iThinkiKhan/Gladiator/hardware/README.md

# Hardware & CAD

Gladiator operates much like a tank: one 12V motor on each track, powered from the battery pack. The tracks give it tremendous all-terrain capability, and the motors have enough torque to really crank the bot forward.

The masthead has pan and tilt. The pan mechanism uses a belt and pulley to get a real 180-degree flip so it can present the display face.

The motor drivers are the main way of getting heat out. Their mounts were designed to look cool, take up minimal room without expanding the bot's footprint, vent heat well, and provide easy access to the electronics. Most of the redesigns have been about access for tools and maintenance. The primary design has remained largely the same.

[Project](../README.md) · [CAD file catalog](cad/catalog.csv) · [Bill of materials](BOM.csv)

## Component snapshots

| Component | Revision note |
| --- | --- |
| [Chassis master](cad/chassis/README.md) | Reference assembly; embedded early head is historical |
| [Mast-front head assembly](cad/head-assembly/README.md) | Viewing assembly; source head prototype v05 |
| [Head v05](cad/head-parts/README.md) | Sensor-mount revision |
| [Camera service mount v2](cad/camera-mount/README.md) | Review assembly and printable tray/lid |
| [Arch rails v4](cad/rails/README.md) | Selected arch rail revision |
| [Upper deck v4](cad/upper-deck/README.md) | Measured rail fit revision |
| [Antenna pylon v3](cad/antenna-pylon/README.md) | Selected pylon revision |
| [INA226 mount v3](cad/power-sensor-mount/README.md) | Selected upright adapter |
| [Switch holder v3](cad/switch-holder/README.md) | Selected rear-open holder |
| [Speaker rail bracket v1](cad/speaker-mount/README.md) | Selected bracket revision |
| [Motor driver mounts v5](cad/motor-driver-mounts/README.md) | Selected interlocking mount revision |
| [Power tray v5](cad/power-tray/README.md) | Selected tray revision |
| [Mast base reprint](cad/mast-base/README.md) | Selected reprint revision |
| [Mast tube v2](cad/mast-tube/README.md) | Only the taller tube; other build2 parts superseded |
| [Round 5 body shell](cad/body-shell/README.md) | Mount-corrected 2.8 mm M2 derivative |
| [Shield emblems v2](cad/shield-emblems/README.md) | Stronger emblems and support cradle; supersedes shell emblem mesh |
| [M2 insert fit coupon](cad/insert-fit-coupon/README.md) | 2.8 mm bore accepted in source notes |

## Planned revisions

[Masthead revisions v1](../docs/PROJECT.md#masthead-revisions-v1)

## Assembly

<!-- WRITE: Your assembly notes. -->

## Printing

<!-- WRITE: Your material, slicer and assembly guidance. -->

Native FreeCAD, STEP and STL snapshots are included. Machine-specific G-code and slicer projects stay in the original source archive. The stronger v2 shield emblems supersede the emblem meshes retained inside the complete shell snapshot.

## Engineering references

[Robot orientation](../docs/reference/ORIENTATION.md) · [Design reference](../docs/reference/GLADIATOR_DESIGN.md) · [Component reference](../docs/reference/components.md)

These are source snapshots, not a newly validated assembled release.
