iThinkiKhan/Gladiator/photos/README.md

# Photos

<!-- WRITE: Gallery introduction. -->

[Project](../README.md)

| Album | Photos |
| --- | ---: |
| [Chassis v1](01-chassis-v1/README.md) | 6 |
| [Chassis assembly](02-chassis-assembly/README.md) | 6 |
| [Robot v1](03-robot-v1/README.md) | 8 |
| [Robot v2](05-robot-v2/README.md) | 2 |
| [Event](06-event/README.md) | 2 |
