iThinkiKhan/Gladiator/photos/01-chassis-v1/README.md

# Chassis v1

<!-- WRITE: Chassis v1 introduction. -->

[All photos](../README.md)

### 20261005_125814.jpg

<!-- WRITE: Caption for 20261005_125814.jpg. -->

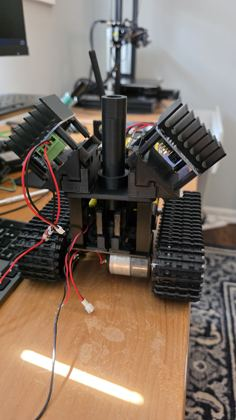
[picture p5: photos/thumbnails/01-chassis-v1/20261005_125814.jpg]
Chassis v1 — 2026-10-05


### 20261005_125831.jpg

<!-- WRITE: Caption for 20261005_125831.jpg. -->

Chassis v1 — 2026-10-05

### 20261005_125851.jpg

<!-- WRITE: Caption for 20261005_125851.jpg. -->

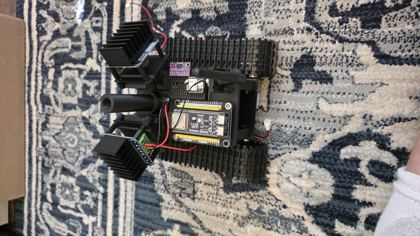
[picture p6: photos/thumbnails/01-chassis-v1/20261005_125851.jpg]
Chassis v1 — 2026-10-05


### 20261005_125855.jpg

<!-- WRITE: Caption for 20261005_125855.jpg. -->

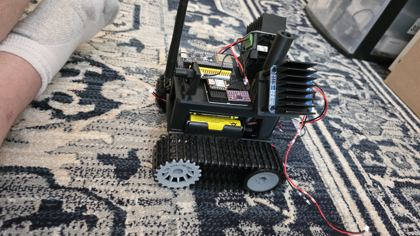
[picture p7: photos/thumbnails/01-chassis-v1/20261005_125855.jpg]
Chassis v1 — 2026-10-05


### 20261005_125901.jpg

<!-- WRITE: Caption for 20261005_125901.jpg. -->

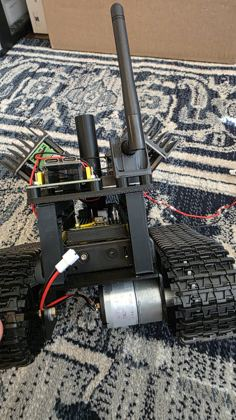
[picture p8: photos/thumbnails/01-chassis-v1/20261005_125901.jpg]
Chassis v1 — 2026-10-05


### 20261005_125914.jpg

<!-- WRITE: Caption for 20261005_125914.jpg. -->

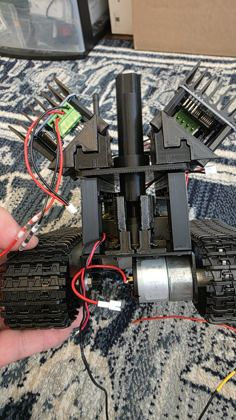
[picture p9: photos/thumbnails/01-chassis-v1/20261005_125914.jpg]
Chassis v1 — 2026-10-05
