iThinkiKhan/Gladiator/photos/04-enclosure-details/README.md

# Enclosure details

<!-- WRITE: Enclosure details introduction. -->

[All photos](../README.md)

### 20261021_211342.jpg

<!-- WRITE: Caption for 20261021_211342.jpg. -->

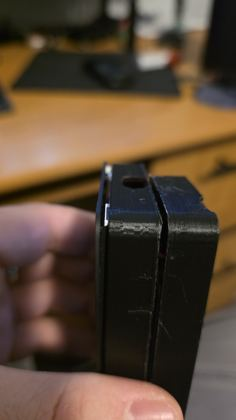
[picture p10: photos/thumbnails/04-enclosure-details/20261021_211342.jpg]
Enclosure details — 2026-10-21


### 20261021_211346.jpg

<!-- WRITE: Caption for 20261021_211346.jpg. -->

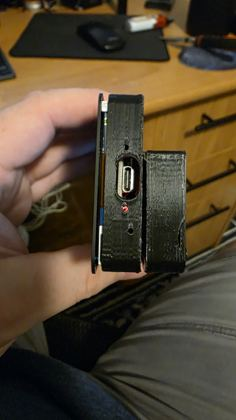
[picture p11: photos/thumbnails/04-enclosure-details/20261021_211346.jpg]
Enclosure details — 2026-10-21


### 20261022_091821.jpg

<!-- WRITE: Caption for 20261022_091821.jpg. -->

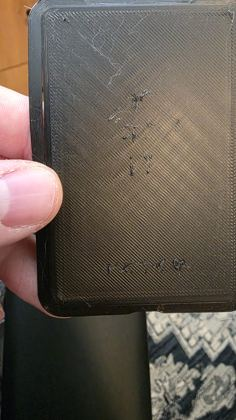
[picture p12: photos/thumbnails/04-enclosure-details/20261022_091821.jpg]
Enclosure details — 2026-10-22
