iThinkiKhan/Gladiator/hardware/cad/antenna-pylon/README.md

# Antenna pylon v3

<!-- WRITE: Antenna pylon v3 notes. -->

Selected pylon revision.

| File | Format |
| --- | --- |
| [Gladiator_AntennaPylon_v3.FCStd](Gladiator_AntennaPylon_v3.FCStd) | FCStd |
| [Gladiator_AntennaPylon_v3.step](Gladiator_AntennaPylon_v3.step) | step |
| [Gladiator_AntennaPylon_v3.stl](Gladiator_AntennaPylon_v3.stl) | stl |
| [pylon_v3_sections.png](pylon_v3_sections.png) | png |

Source revision: `v2/antenna-pylon/v3-20261014` in [gladiator-cad](https://github.com/iThinkiKhan/gladiator-cad/tree/db25f68d589b59520871f2c27f7898625261f611/cad/v2/antenna-pylon/v3-20261014).

[CAD index](../../README.md)
