iThinkiKhan/Gladiator/hardware/cad/body-shell/README.md

# Round 5 body shell

<!-- WRITE: Round 5 body shell notes. -->

Mount-corrected 2.8 mm M2 derivative.

| File | Format |
| --- | --- |
| [Gladiator_Round5_Print.FCStd](Gladiator_Round5_Print.FCStd) | FCStd |
| [Gladiator_Round5_PrintParts.step](Gladiator_Round5_PrintParts.step) | step |
| [Aquila_Relief.stl](stl/Aquila_Relief.stl) | stl |
| [Crest_Clamp.stl](stl/Crest_Clamp.stl) | stl |
| [Crest_Clamp_Shoe.stl](stl/Crest_Clamp_Shoe.stl) | stl |
| [Crest_Holder_Trim.stl](stl/Crest_Holder_Trim.stl) | stl |
| [Front_Left.stl](stl/Front_Left.stl) | stl |
| [Front_Right.stl](stl/Front_Right.stl) | stl |
| [Galea_Crest.stl](stl/Galea_Crest.stl) | stl |
| [Lens_Plate.stl](stl/Lens_Plate.stl) | stl |
| [Neck_Clamp_0.stl](stl/Neck_Clamp_0.stl) | stl |
| [Neck_Clamp_1.stl](stl/Neck_Clamp_1.stl) | stl |
| [Neck_Clamp_Shoe_21_5.stl](stl/Neck_Clamp_Shoe_21_5.stl) | stl |
| [Neck_Clamp_Shoe_57_5.stl](stl/Neck_Clamp_Shoe_57_5.stl) | stl |
| [Neck_Guard.stl](stl/Neck_Guard.stl) | stl |
| [Rear_Hood.stl](stl/Rear_Hood.stl) | stl |
| [Scutum_Boss_L.stl](stl/Scutum_Boss_L.stl) | stl |
| [Scutum_Boss_R.stl](stl/Scutum_Boss_R.stl) | stl |
| [Scutum_Emblem_L.stl](stl/Scutum_Emblem_L.stl) | stl |
| [Scutum_Emblem_R.stl](stl/Scutum_Emblem_R.stl) | stl |
| [Scutum_Field_L.stl](stl/Scutum_Field_L.stl) | stl |
| [Scutum_Field_R.stl](stl/Scutum_Field_R.stl) | stl |
| [Tablet_L.stl](stl/Tablet_L.stl) | stl |
| [Tablet_R.stl](stl/Tablet_R.stl) | stl |

Source revision: `v2/enclosure/round5-calibrated-28-20261022/mount-checked-release/DELIVERY/CAD` in [gladiator-cad](https://github.com/iThinkiKhan/gladiator-cad/tree/db25f68d589b59520871f2c27f7898625261f611/cad/v2/enclosure/round5-calibrated-28-20261022/mount-checked-release/DELIV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).

[CAD index](../../README.md)
