iThinkiKhan/Gladiator/hardware/cad/camera-mount/README.md

# Camera service mount v2

<!-- WRITE: Camera service mount v2 notes. -->

Review assembly and printable tray/lid.

| File | Format |
| --- | --- |
| [assembled.png](assembled.png) | png |
| [exploded.png](exploded.png) | png |
| [Gladiator_Camera_Service_v2.step](Gladiator_Camera_Service_v2.step) | step |
| [Gladiator_Camera_Service_v2_REVIEW.FCStd](Gladiator_Camera_Service_v2_REVIEW.FCStd) | FCStd |
| [Camera_Service_v2_Lid.stl](stl/Camera_Service_v2_Lid.stl) | stl |
| [Camera_Service_v2_Tray.stl](stl/Camera_Service_v2_Tray.stl) | stl |

Source revision: `head/camera-service-v2-20261021` in [gladiator-cad](https://github.com/iThinkiKhan/gladiator-cad/tree/db25f68d589b59520871f2c27f7898625261f611/cad/head/camera-service-v2-20261021).

[CAD index](../../README.md)
