iThinkiKhan/Gladiator/hardware/cad/chassis/README.md

# Chassis master

<!-- WRITE: Chassis master notes. -->

Reference assembly; embedded early head is historical.

| File | Format |
| --- | --- |
| [Gladiator_Master.FCStd](Gladiator_Master.FCStd) | FCStd |
| [Gladiator_Master.step](Gladiator_Master.step) | step |

Source revision: `master` in [gladiator-cad](https://github.com/iThinkiKhan/gladiator-cad/tree/db25f68d589b59520871f2c27f7898625261f611/cad/master).

[CAD index](../../README.md)
