iThinkiKhan/Gladiator/hardware/cad/insert-fit-coupon/README.md

# M2 insert fit coupon

<!-- WRITE: M2 insert fit coupon notes. -->

2.8 mm bore accepted in source notes.

| File | Format |
| --- | --- |
| [M2_D3_L3_Coupon.FCStd](M2_D3_L3_Coupon.FCStd) | FCStd |
| [M2_D3_L3_Coupon.step](M2_D3_L3_Coupon.step) | step |
| [M2_D3_L3_Coupon.stl](M2_D3_L3_Coupon.stl) | stl |

Source revision: `coupons/m2-d3-l3-mini-20261022` in [gladiator-cad](https://github.com/iThinkiKhan/gladiator-cad/tree/db25f68d589b59520871f2c27f7898625261f611/cad/coupons/m2-d3-l3-mini-20261022).

[CAD index](../../README.md)
