iThinkiKhan/Gladiator/hardware/cad/mast-base/README.md

# Mast base reprint

<!-- WRITE: Mast base reprint notes. -->

Selected reprint revision.

| File | Format |
| --- | --- |
| [Gladiator_MastBase_spigot-3p5_chamfer-0p8_UP.stl](Gladiator_MastBase_spigot-3p5_chamfer-0p8_UP.stl) | stl |
| [Gladiator_Master_MastBase_short-spigot.FCStd](Gladiator_Master_MastBase_short-spigot.FCStd) | FCStd |

Source revision: `mast-base/reprint-20260926` in [gladiator-cad](https://github.com/iThinkiKhan/gladiator-cad/tree/db25f68d589b59520871f2c27f7898625261f611/cad/mast-base/reprint-20260926).

[CAD index](../../README.md)
