iThinkiKhan/Gladiator/hardware/cad/mast-tube/README.md

# Mast tube v2

<!-- WRITE: Mast tube v2 notes. -->

Only the taller tube; other build2 parts superseded.

| File | Format |
| --- | --- |
| [Gladiator_MastTube_v2-Z130_print-vertical.stl](Gladiator_MastTube_v2-Z130_print-vertical.stl) | stl |

Source revision: `build2-20260927` in [gladiator-cad](https://github.com/iThinkiKhan/gladiator-cad/tree/db25f68d589b59520871f2c27f7898625261f611/cad/build2-20260927).

[CAD index](../../README.md)
