iThinkiKhan/Gladiator/hardware/cad/motor-driver-mounts/README.md

# Motor driver mounts v5

<!-- WRITE: Motor driver mounts v5 notes. -->

Selected interlocking mount revision.

| File | Format |
| --- | --- |
| [DriverMount_v5.FCStd](DriverMount_v5.FCStd) | FCStd |
| [DriverMount_v5.step](DriverMount_v5.step) | step |
| [Base_Left.stl](stl/Base_Left.stl) | stl |
| [Wedge_Left.stl](stl/Wedge_Left.stl) | stl |

Source revision: `drivers/v5-interlock` in [gladiator-cad](https://github.com/iThinkiKhan/gladiator-cad/tree/db25f68d589b59520871f2c27f7898625261f611/cad/drivers/v5-interlock).

[CAD index](../../README.md)
