iThinkiKhan/Gladiator/hardware/cad/power-sensor-mount/README.md

# INA226 mount v3

<!-- WRITE: INA226 mount v3 notes. -->

Selected upright adapter.

| File | Format |
| --- | --- |
| [Gladiator_INA_Mount_v3.FCStd](Gladiator_INA_Mount_v3.FCStd) | FCStd |
| [Gladiator_INA_Mount_v3.step](Gladiator_INA_Mount_v3.step) | step |
| [Gladiator_INA_Mount_v3.stl](Gladiator_INA_Mount_v3.stl) | stl |

Source revision: `v2/ina-mount/v3-20261019` in [gladiator-cad](https://github.com/iThinkiKhan/gladiator-cad/tree/db25f68d589b59520871f2c27f7898625261f611/cad/v2/ina-mount/v3-20261019).

[CAD index](../../README.md)
