iThinkiKhan/Gladiator/hardware/cad/power-tray/README.md

# Power tray v5

<!-- WRITE: Power tray v5 notes. -->

Selected tray revision.

| File | Format |
| --- | --- |
| [PowerBoardTray_v5.FCStd](PowerBoardTray_v5.FCStd) | FCStd |
| [PowerBoardTray_v5.step](PowerBoardTray_v5.step) | step |
| [Gladiator_PowerTray_v5_BaseLeft_print-tab-down.stl](stl/Gladiator_PowerTray_v5_BaseLeft_print-tab-down.stl) | stl |
| [Gladiator_PowerTray_v5_BaseRight_print-tab-down.stl](stl/Gladiator_PowerTray_v5_BaseRight_print-tab-down.stl) | stl |
| [Gladiator_PowerTray_v5_FitCoupon_base-and-peg.stl](stl/Gladiator_PowerTray_v5_FitCoupon_base-and-peg.stl) | stl |
| [Gladiator_PowerTray_v5_print-on-rear-face.stl](stl/Gladiator_PowerTray_v5_print-on-rear-face.stl) | stl |
| [PowerBoardTray_v5_installed.stl](stl/PowerBoardTray_v5_installed.stl) | stl |

Source revision: `power-board/v5-tray` in [gladiator-cad](https://github.com/iThinkiKhan/gladiator-cad/tree/db25f68d589b59520871f2c27f7898625261f611/cad/power-board/v5-tray).

[CAD index](../../README.md)
