iThinkiKhan/Gladiator/hardware/cad/rails/README.md

# Arch rails v4

<!-- WRITE: Arch rails v4 notes. -->

Selected arch rail revision.

| File | Format |
| --- | --- |
| [arch_rails_v4_sections.png](arch_rails_v4_sections.png) | png |
| [Gladiator_Arch_Rail_Left_v4.stl](Gladiator_Arch_Rail_Left_v4.stl) | stl |
| [Gladiator_Arch_Rail_Right_v4.stl](Gladiator_Arch_Rail_Right_v4.stl) | stl |
| [Gladiator_ArchRails_v4.FCStd](Gladiator_ArchRails_v4.FCStd) | FCStd |
| [Gladiator_ArchRails_v4.step](Gladiator_ArchRails_v4.step) | step |

Source revision: `v2/rails/v4-20261015` in [gladiator-cad](https://github.com/iThinkiKhan/gladiator-cad/tree/db25f68d589b59520871f2c27f7898625261f611/cad/v2/rails/v4-20261015).

[CAD index](../../README.md)
