iThinkiKhan/Gladiator/hardware/cad/shield-emblems/README.md

# Shield emblems v2

<!-- WRITE: Shield emblems v2 notes. -->

Stronger emblems and support cradle; supersedes shell emblem mesh.

| File | Format |
| --- | --- |
| [Emblem_Cradle.stl](Emblem_Cradle.stl) | stl |
| [emblem_old_right_v2_left.png](emblem_old_right_v2_left.png) | png |
| [Scutum_Emblem_v2.FCStd](Scutum_Emblem_v2.FCStd) | FCStd |
| [Scutum_Emblem_v2.stl](Scutum_Emblem_v2.stl) | stl |

Source revision: `v2/enclosure/round5-print-20261022/emblem-v2` in [gladiator-cad](https://github.com/iThinkiKhan/gladiator-cad/tree/db25f68d589b59520871f2c27f7898625261f611/cad/v2/enclosure/round5-print-20261022/emblem-v2).

[CAD index](../../README.md)
