iThinkiKhan/Gladiator/hardware/cad/speaker-mount/README.md

# Speaker rail bracket v1

<!-- WRITE: Speaker rail bracket v1 notes. -->

Selected bracket revision.

| File | Format |
| --- | --- |
| [Gladiator_Speaker_Rail_Bracket_v1.FCStd](Gladiator_Speaker_Rail_Bracket_v1.FCStd) | FCStd |
| [Gladiator_Speaker_Rail_Bracket_v1.step](Gladiator_Speaker_Rail_Bracket_v1.step) | step |
| [Gladiator_Speaker_Rail_Bracket_v1.stl](Gladiator_Speaker_Rail_Bracket_v1.stl) | stl |

Source revision: `v2/speaker-mount/v1-20261020` in [gladiator-cad](https://github.com/iThinkiKhan/gladiator-cad/tree/db25f68d589b59520871f2c27f7898625261f611/cad/v2/speaker-mount/v1-20261020).

[CAD index](../../README.md)
