iThinkiKhan/Gladiator/hardware/cad/switch-holder/README.md

# Switch holder v3

<!-- WRITE: Switch holder v3 notes. -->

Selected rear-open holder.

| File | Format |
| --- | --- |
| [Gladiator_SwitchHolder_v3.FCStd](Gladiator_SwitchHolder_v3.FCStd) | FCStd |
| [Gladiator_SwitchHolder_v3.step](Gladiator_SwitchHolder_v3.step) | step |
| [Gladiator_SwitchHolder_v3.stl](Gladiator_SwitchHolder_v3.stl) | stl |

Source revision: `v2/switch-enclosure/v3-20261016` in [gladiator-cad](https://github.com/iThinkiKhan/gladiator-cad/tree/db25f68d589b59520871f2c27f7898625261f611/cad/v2/switch-enclosure/v3-20261016).

[CAD index](../../README.md)
