iThinkiKhan/Gladiator/hardware/cad/upper-deck/README.md

# Upper deck v4

<!-- WRITE: Upper deck v4 notes. -->

Measured rail fit revision.

| File | Format |
| --- | --- |
| [Gladiator_UpperDeck_v4.FCStd](Gladiator_UpperDeck_v4.FCStd) | FCStd |
| [Gladiator_UpperDeck_v4.step](Gladiator_UpperDeck_v4.step) | step |
| [Gladiator_UpperDeck_v4.stl](Gladiator_UpperDeck_v4.stl) | stl |

Source revision: `v2/upper-deck/v4-20261016` in [gladiator-cad](https://github.com/iThinkiKhan/gladiator-cad/tree/db25f68d589b59520871f2c27f7898625261f611/cad/v2/upper-deck/v4-20261016).

[CAD index](../../README.md)
