iThinkiKhan/Gladiator/docs/EDITING.md

# Writing your project

- [Main README](../README.md): review the opening and status in your words; add features, credits and licensing.
- [Project story](PROJECT.md): your origin story, power board, body redesign and next steps; refine or extend it as we go.
- [Build log](BUILD_LOG.md): your notes beside each linked photo album.
- [Hardware](../hardware/README.md): assembly and printing guidance.
- [Bill of materials](../hardware/BOM.csv): fill quantities, specifications and notes.
- [Firmware](../firmware/README.md): add your software overview above the build reference.
- [Photo albums](../photos/README.md): fill each introduction and caption.

Search for `<!-- WRITE:` to find each writing slot. Comments are hidden in the rendered pages. Leave source code and generated catalogs alone unless you are changing the project itself.

Choose licensing for code, hardware, and photos, and add any required third-party credits before describing this as an open-source release. No license was selected on your behalf.
