iThinkiKhan/Gladiator/photos/06-event/README.md

# Event

<!-- WRITE: Event introduction. -->

[All photos](../README.md)

### 20261024_125802.jpg

<!-- WRITE: Caption for 20261024_125802.jpg. -->

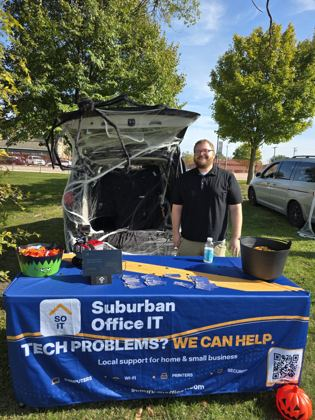
[picture p13: photos/thumbnails/06-event/20261024_125802.jpg]
Event — 2026-10-24


### 20261024_125804.jpg

<!-- WRITE: Caption for 20261024_125804.jpg. -->

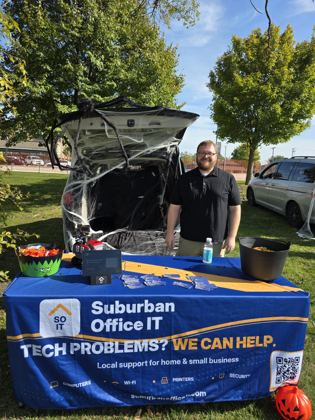
[picture p14: photos/thumbnails/06-event/20261024_125804.jpg]
Event — 2026-10-24
