iThinkiKhan/Gladiator/photos/03-robot-v1/README.md

# Robot v1

<!-- WRITE: Robot v1 introduction. -->

[All photos](../README.md)

### 20261014_103027.jpg

<!-- WRITE: Caption for 20261014_103027.jpg. -->

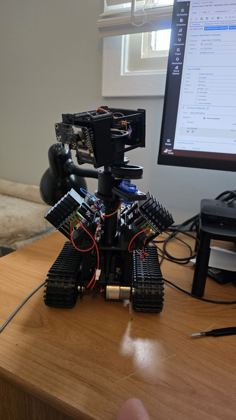
[picture p15: photos/thumbnails/03-robot-v1/20261014_103027.jpg]
Robot v1 — 2026-10-14


### 20261014_103030.jpg

<!-- WRITE: Caption for 20261014_103030.jpg. -->

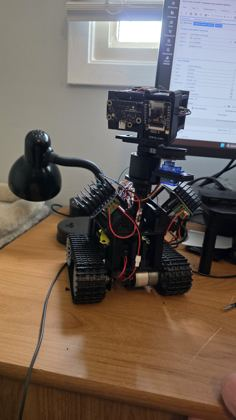
[picture p16: photos/thumbnails/03-robot-v1/20261014_103030.jpg]
Robot v1 — 2026-10-14


### 20261014_114522.jpg

<!-- WRITE: Caption for 20261014_114522.jpg. -->

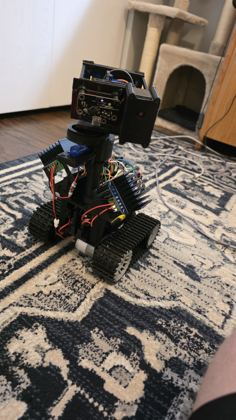
[picture p17: photos/thumbnails/03-robot-v1/20261014_114522.jpg]
Robot v1 — 2026-10-14


### 20261014_114531.jpg

<!-- WRITE: Caption for 20261014_114531.jpg. -->

Robot v1 — 2026-10-14

### 20261014_114604.jpg

<!-- WRITE: Caption for 20261014_114604.jpg. -->

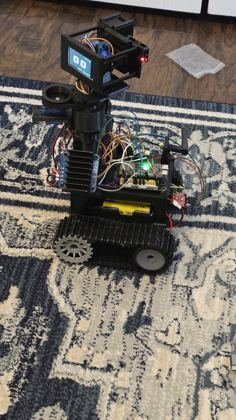
[picture p18: photos/thumbnails/03-robot-v1/20261014_114604.jpg]
Robot v1 — 2026-10-14


### 20261014_160522.jpg

<!-- WRITE: Caption for 20261014_160522.jpg. -->

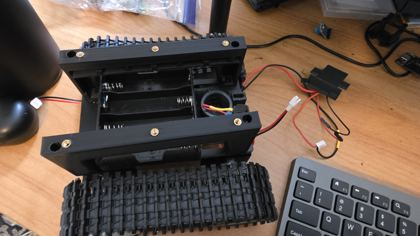
[picture p19: photos/thumbnails/03-robot-v1/20261014_160522.jpg]
Robot v1 — 2026-10-14


### 20261014_160528.jpg

<!-- WRITE: Caption for 20261014_160528.jpg. -->

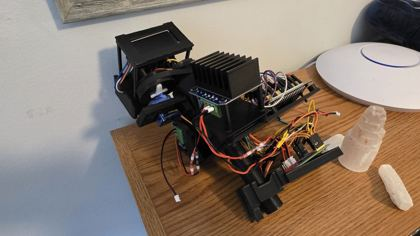
[picture p20: photos/thumbnails/03-robot-v1/20261014_160528.jpg]
Robot v1 — 2026-10-14


### 20261014_160530.jpg

<!-- WRITE: Caption for 20261014_160530.jpg. -->

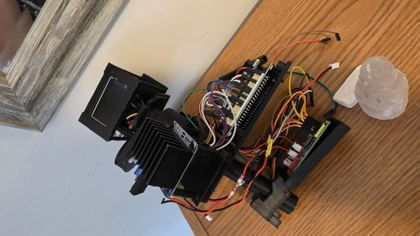
[picture p21: photos/thumbnails/03-robot-v1/20261014_160530.jpg]
Robot v1 — 2026-10-14
