iThinkiKhan/Gladiator/photos/05-robot-v2/README.md

# Robot v2

<!-- WRITE: Robot v2 introduction. -->

[All photos](../README.md)

### 20261026_121424.jpg

<!-- WRITE: Caption for 20261026_121424.jpg. -->

Robot v2 — 2026-10-26

### 20261026_121446.jpg

<!-- WRITE: Caption for 20261026_121446.jpg. -->

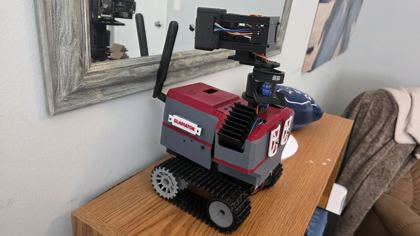
[picture p22: photos/thumbnails/05-robot-v2/20261026_121446.jpg]
Robot v2 — 2026-10-26
