iThinkiKhan/Gladiator/hardware/cad/antenna-pylon/pylon_v3_sections.png

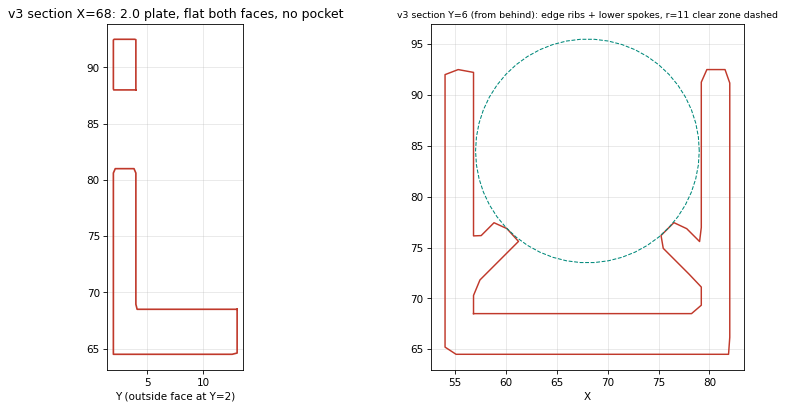
hardware/cad/antenna-pylon/pylon_v3_sections.png
