iThinkiKhan/Gladiator/hardware/cad/camera-mount/exploded.png

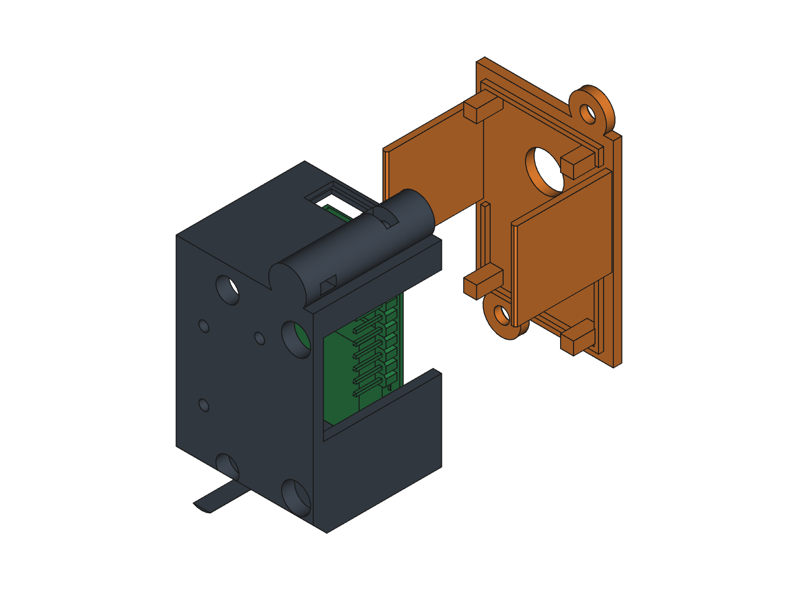
hardware/cad/camera-mount/exploded.png
