iThinkiKhan/Gladiator/hardware/cad/rails/arch_rails_v4_sections.png

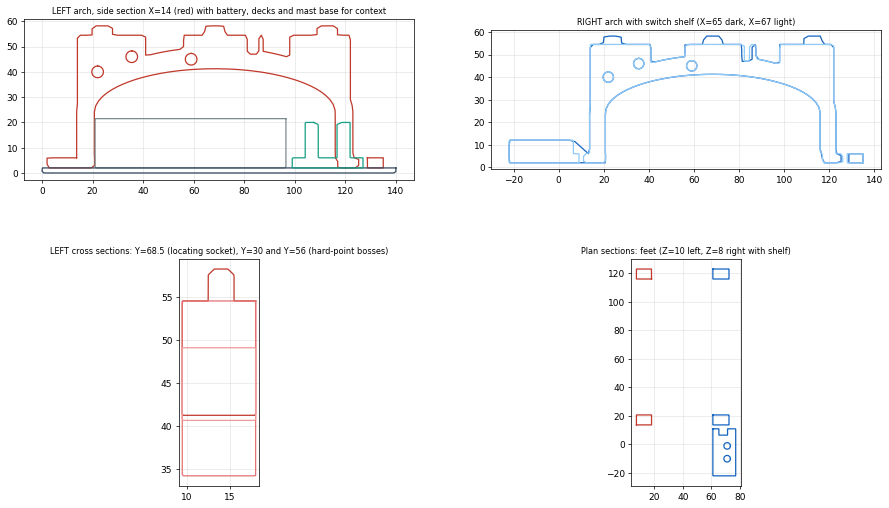
hardware/cad/rails/arch_rails_v4_sections.png
