iThinkiKhan/Gladiator/photos/06-event/20261024_134534.jpg

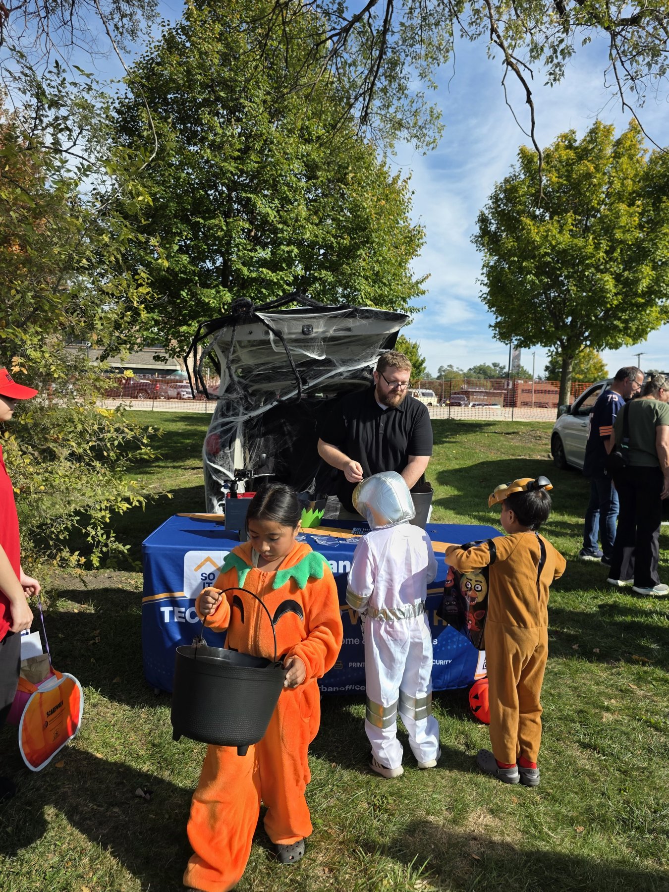
photos/06-event/20261024_134534.jpg
