iThinkiKhan/Gladiator/photos/06-event/20261024_134554.jpg

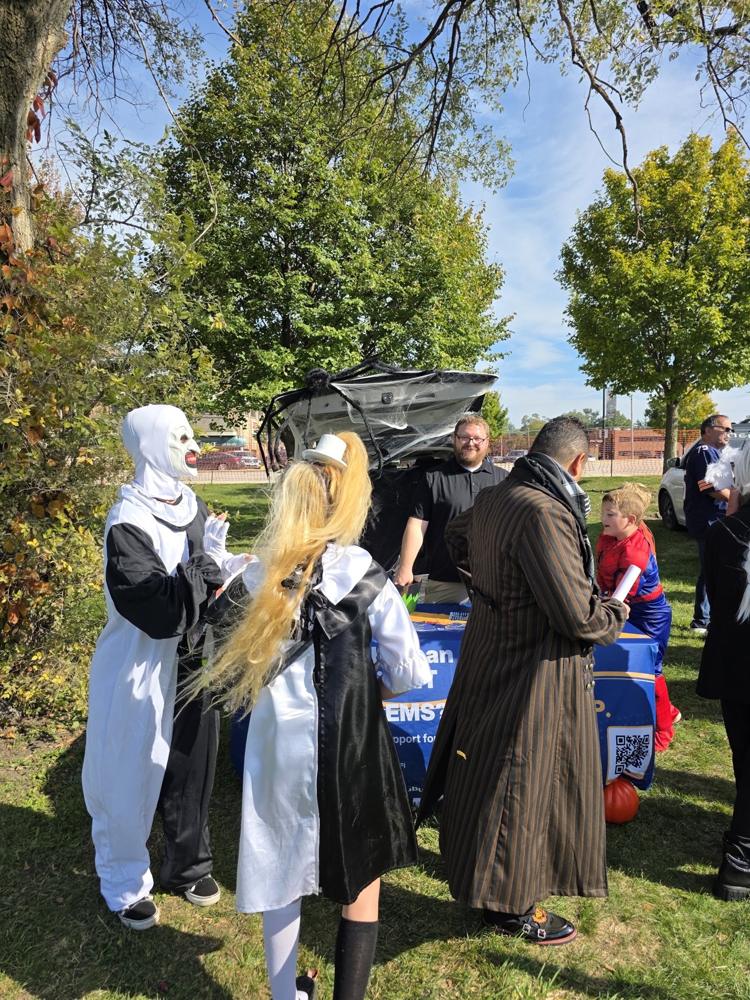
photos/06-event/20261024_134554.jpg
