iThinkiKhan/Gladiator/photos/06-event/20261024_141302.jpg

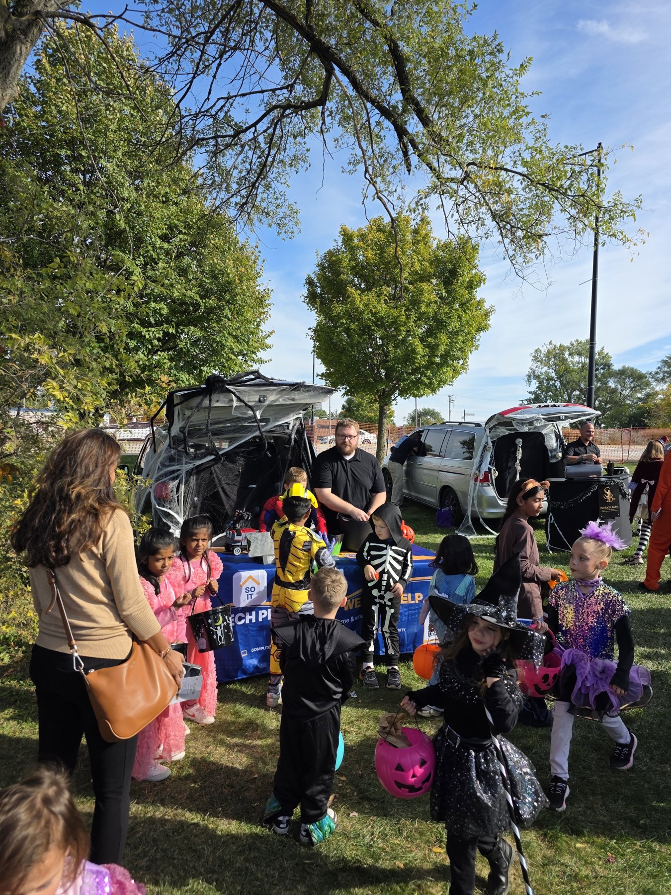
photos/06-event/20261024_141302.jpg
