iThinkiKhan/Gladiator/hardware/cad/head-parts/README.md

# Head v05

<!-- WRITE: Head v05 notes. -->

Sensor-mount revision.

| File | Format |
| --- | --- |
| [Gladiator_Head_v05_PanStack.FCStd](Gladiator_Head_v05_PanStack.FCStd) | FCStd |
| [Gladiator_Head_v05_PanStack.step](Gladiator_Head_v05_PanStack.step) | step |
| [sensor-mounts.png](sensor-mounts.png) | png |
| [Gladiator_Head_v05_GH44_Dual_Carrier.stl](stl/Gladiator_Head_v05_GH44_Dual_Carrier.stl) | stl |
| [Gladiator_Head_v05_GH44_Tilt_Receiver.stl](stl/Gladiator_Head_v05_GH44_Tilt_Receiver.stl) | stl |
| [Gladiator_Head_v05_Neck_Clamp_Cap.stl](stl/Gladiator_Head_v05_Neck_Clamp_Cap.stl) | stl |
| [Gladiator_Head_v05_Neck_Main.stl](stl/Gladiator_Head_v05_Neck_Main.stl) | stl |
| [Gladiator_Head_v05_Pan_Drive_Pulley.stl](stl/Gladiator_Head_v05_Pan_Drive_Pulley.stl) | stl |
| [Gladiator_Head_v05_Pan_Raised_Pedestal.stl](stl/Gladiator_Head_v05_Pan_Raised_Pedestal.stl) | stl |
| [Gladiator_Head_v05_Pan_Retainer.stl](stl/Gladiator_Head_v05_Pan_Retainer.stl) | stl |
| [Gladiator_Head_v05_Pan_Rotor.stl](stl/Gladiator_Head_v05_Pan_Rotor.stl) | stl |
| [Gladiator_Head_v05_Pan_Servo_Carriage.stl](stl/Gladiator_Head_v05_Pan_Servo_Carriage.stl) | stl |
| [Gladiator_Head_v05_Radar_Sensor_Frame.stl](stl/Gladiator_Head_v05_Radar_Sensor_Frame.stl) | stl |
| [Gladiator_Head_v05_Rear_Display_Frame.stl](stl/Gladiator_Head_v05_Rear_Display_Frame.stl) | stl |
| [Gladiator_Head_v05_Tilt_Yoke.stl](stl/Gladiator_Head_v05_Tilt_Yoke.stl) | stl |
| [Gladiator_Head_v05_ToF_Sensor_Frame.stl](stl/Gladiator_Head_v05_ToF_Sensor_Frame.stl) | stl |

Source revision: `head/v05-sensor-mounts` in [gladiator-cad](https://github.com/iThinkiKhan/gladiator-cad/tree/db25f68d589b59520871f2c27f7898625261f611/cad/head/v05-sensor-mounts).

[CAD index](../../README.md)
