iThinkiKhan/Gladiator/hardware/cad/head-parts/sensor-mounts.png

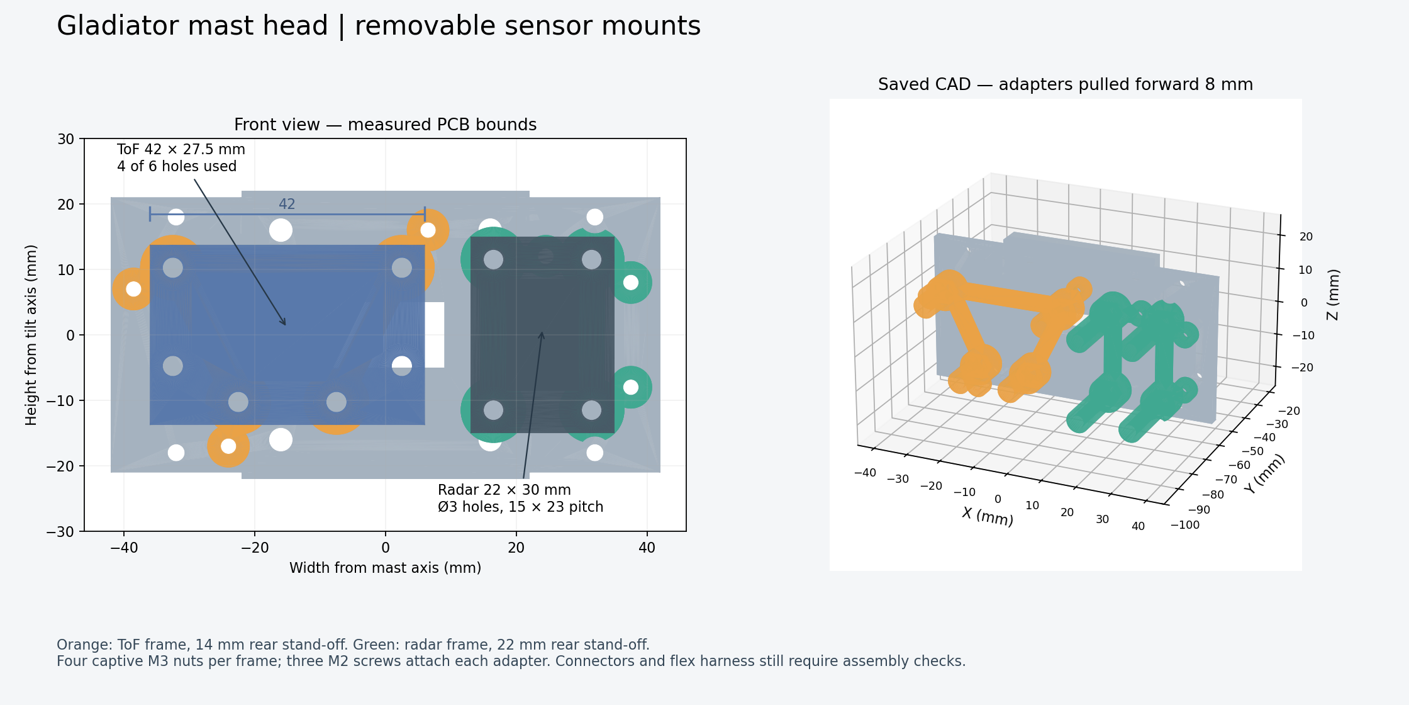
hardware/cad/head-parts/sensor-mounts.png
