iThinkiKhan/Gladiator/hardware/cad/head-parts/stl/Gladiator_Head_v05_Neck_Main.stl

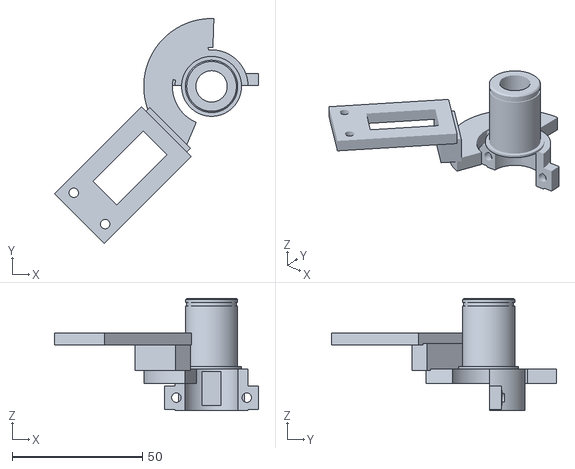
[picture p32: CAD file, 2026-10-26]
hardware/cad/head-parts/stl/Gladiator_Head_v05_Neck_Main.stl
78.2 x 86.2 x 43.1
