iThinkiKhan/Gladiator/hardware/cad/antenna-pylon/Gladiator_AntennaPylon_v3.step

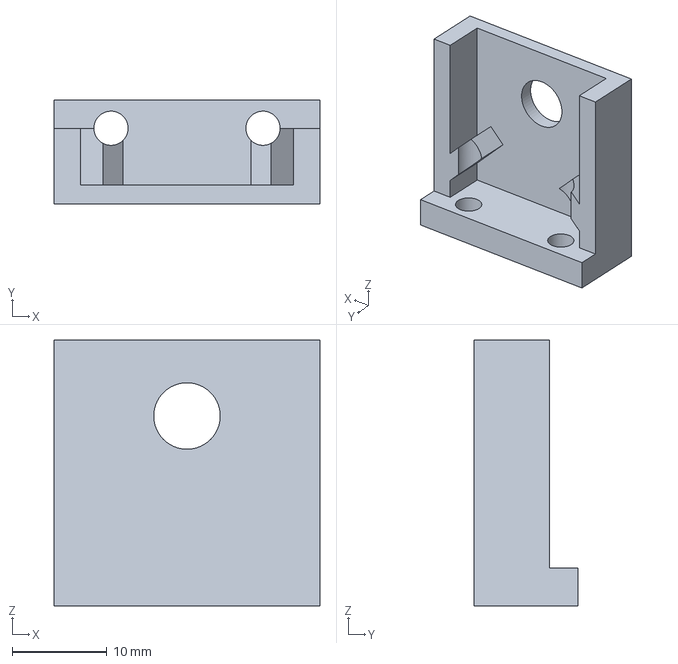
[picture p33: CAD file, 2026-10-26]
hardware/cad/antenna-pylon/Gladiator_AntennaPylon_v3.step
28.0 x 11.0 x 28.0 mm
