iThinkiKhan/Gladiator/hardware/cad/body-shell/Gladiator_Round5_PrintParts.step

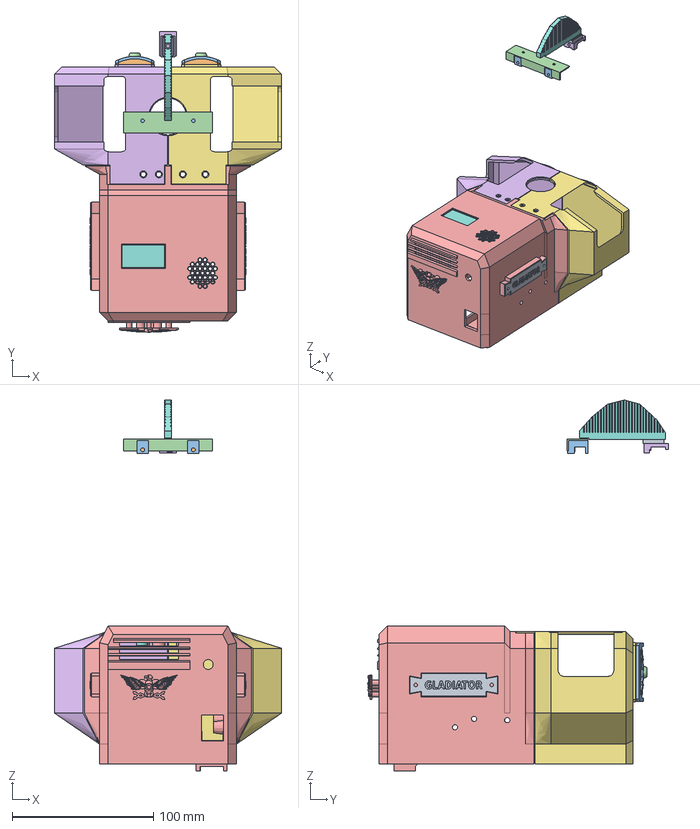
[picture p34: CAD file, 2026-10-26]
hardware/cad/body-shell/Gladiator_Round5_PrintParts.step
161.0 x 213.4 x 263.0 mm
