iThinkiKhan/Gladiator/hardware/cad/body-shell/stl/Front_Right.stl

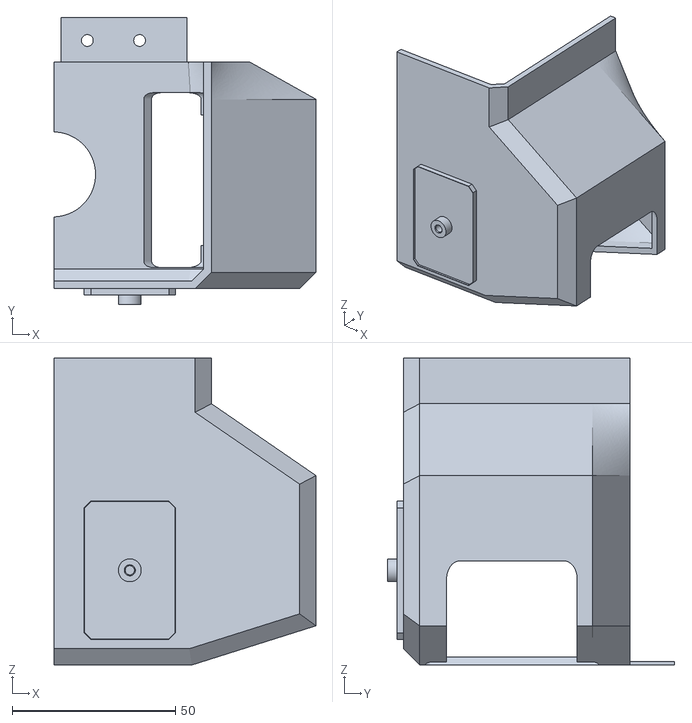
[picture p35: CAD file, 2026-10-26]
hardware/cad/body-shell/stl/Front_Right.stl
80.2 x 87.8 x 94.0
