iThinkiKhan/Gladiator/hardware/cad/camera-mount/Gladiator_Camera_Service_v2.step

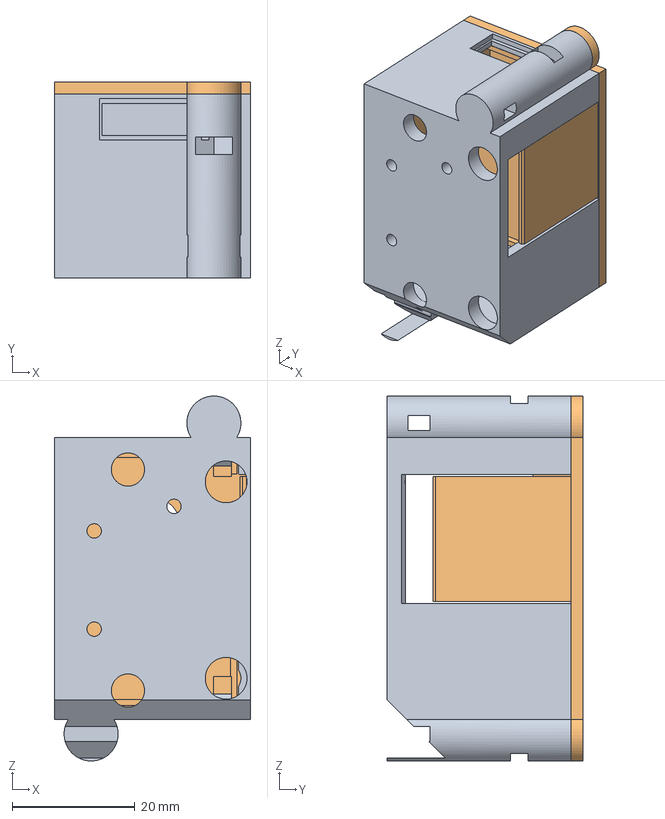
[picture p36: CAD file, 2026-10-26]
hardware/cad/camera-mount/Gladiator_Camera_Service_v2.step
32.0 x 32.0 x 59.4 mm
Mount_Tray
Screw_Cover
