iThinkiKhan/Gladiator/hardware/cad/camera-mount/stl/Camera_Service_v2_Lid.stl

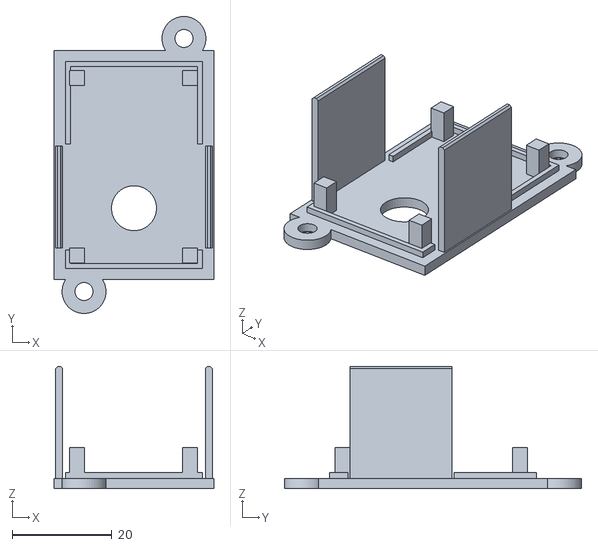
[picture p37: CAD file, 2026-10-26]
hardware/cad/camera-mount/stl/Camera_Service_v2_Lid.stl
32.0 x 59.4 x 24.5
