iThinkiKhan/Gladiator/hardware/cad/chassis/Gladiator_Master.step

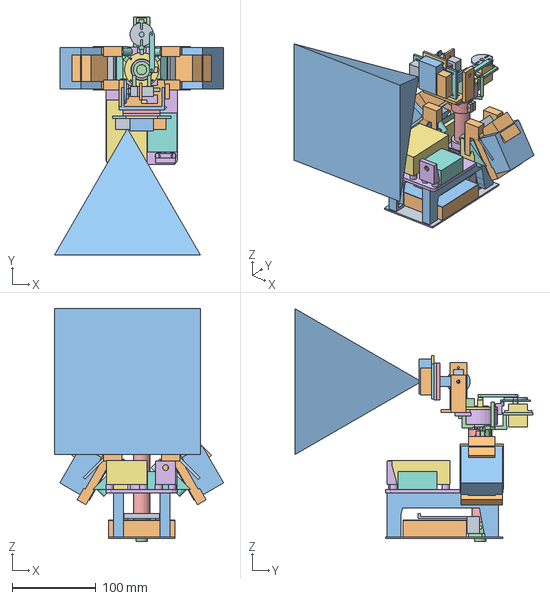
[picture p38: CAD file, 2026-10-26]
hardware/cad/chassis/Gladiator_Master.step
201.7 x 284.1 x 277.6 mm
