iThinkiKhan/Gladiator/hardware/cad/head-parts/Gladiator_Head_v05_PanStack.step

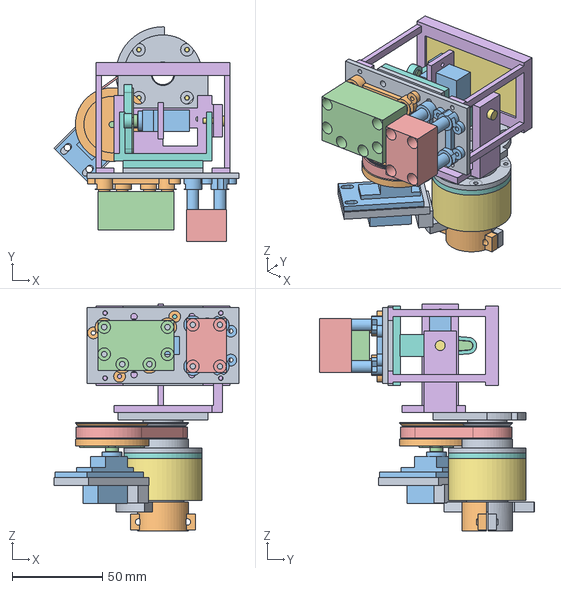
[picture p40: CAD file, 2026-10-26]
hardware/cad/head-parts/Gladiator_Head_v05_PanStack.step
102.2 x 118.6 x 125.5 mm
