iThinkiKhan/Gladiator/hardware/cad/head-parts/stl/Gladiator_Head_v05_ToF_Sensor_Frame.stl

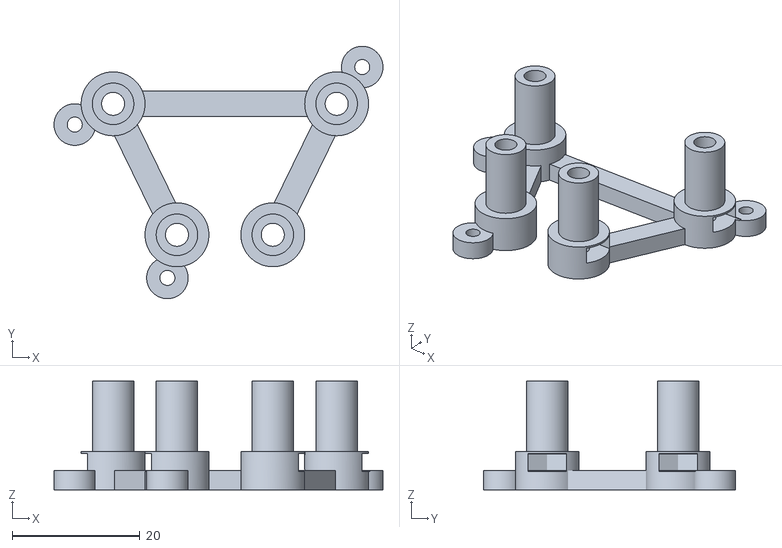
[picture p41: CAD file, 2026-10-26]
hardware/cad/head-parts/stl/Gladiator_Head_v05_ToF_Sensor_Frame.stl
51.5 x 39.5 x 17.0
