iThinkiKhan/Gladiator/hardware/cad/insert-fit-coupon/M2_D3_L3_Coupon.step

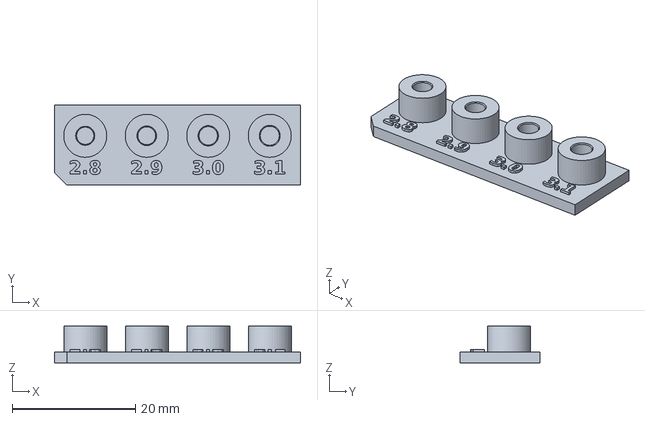
[picture p42: CAD file, 2026-10-26]
hardware/cad/insert-fit-coupon/M2_D3_L3_Coupon.step
40.0 x 13.0 x 6.00 mm
