iThinkiKhan/Gladiator/hardware/cad/mast-base/Gladiator_MastBase_spigot-3p5_chamfer-0p8_UP.stl

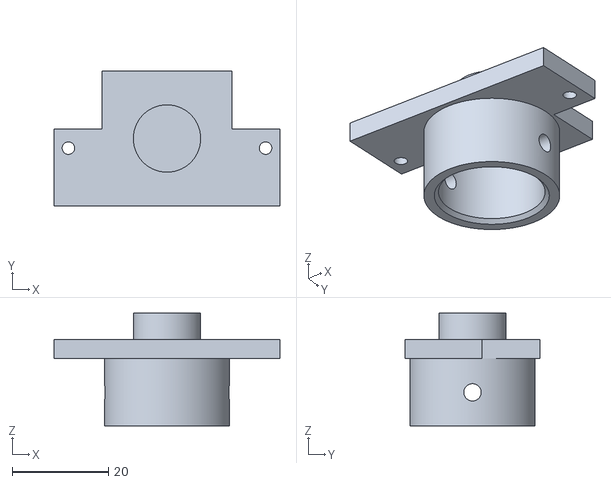
[picture p43: CAD file, 2026-10-26]
hardware/cad/mast-base/Gladiator_MastBase_spigot-3p5_chamfer-0p8_UP.stl
47.0 x 28.0 x 23.5
