iThinkiKhan/Gladiator/hardware/cad/mast-tube/Gladiator_MastTube_v2-Z130_print-vertical.stl

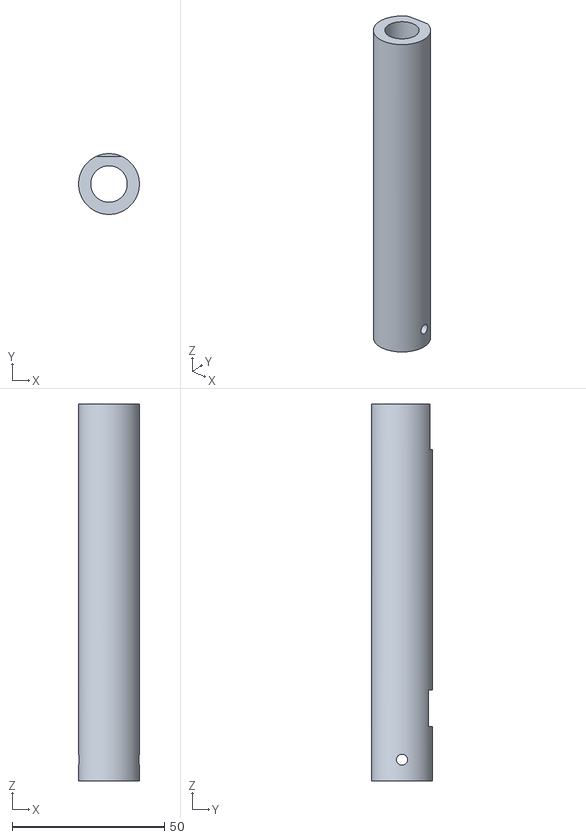
[picture p44: CAD file, 2026-10-26]
hardware/cad/mast-tube/Gladiator_MastTube_v2-Z130_print-vertical.stl
20.0 x 20.0 x 124.0
