iThinkiKhan/Gladiator/hardware/cad/motor-driver-mounts/DriverMount_v5.step

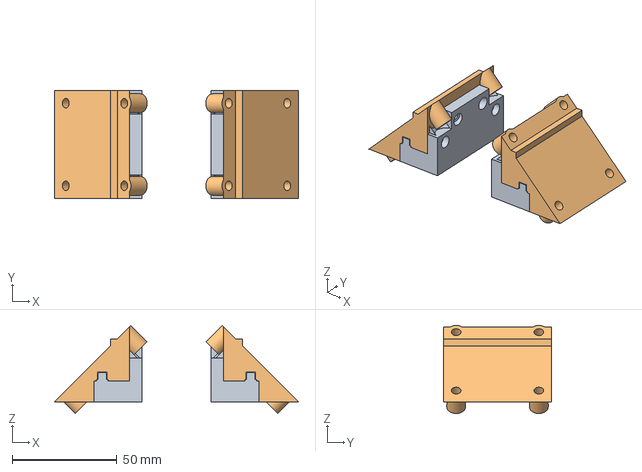
[picture p45: CAD file, 2026-10-26]
hardware/cad/motor-driver-mounts/DriverMount_v5.step
116.6 x 51.5 x 42.1 mm
