iThinkiKhan/Gladiator/hardware/cad/motor-driver-mounts/stl/Wedge_Left.stl

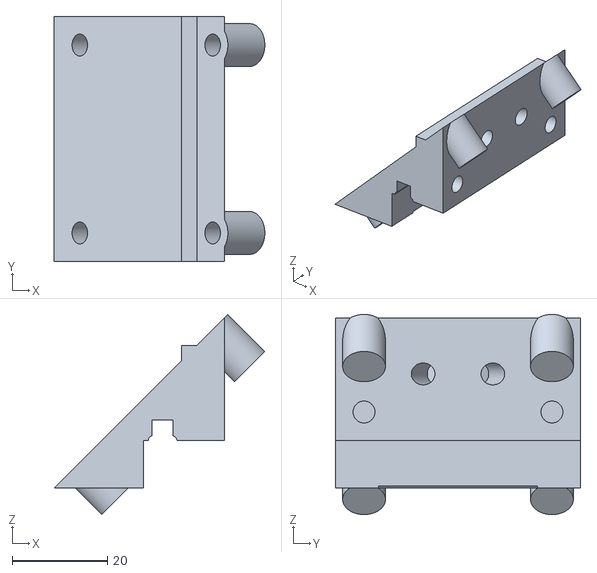
[picture p46: CAD file, 2026-10-26]
hardware/cad/motor-driver-mounts/stl/Wedge_Left.stl
44.3 x 51.5 x 42.1
