iThinkiKhan/Gladiator/hardware/cad/power-sensor-mount/Gladiator_INA_Mount_v3.step

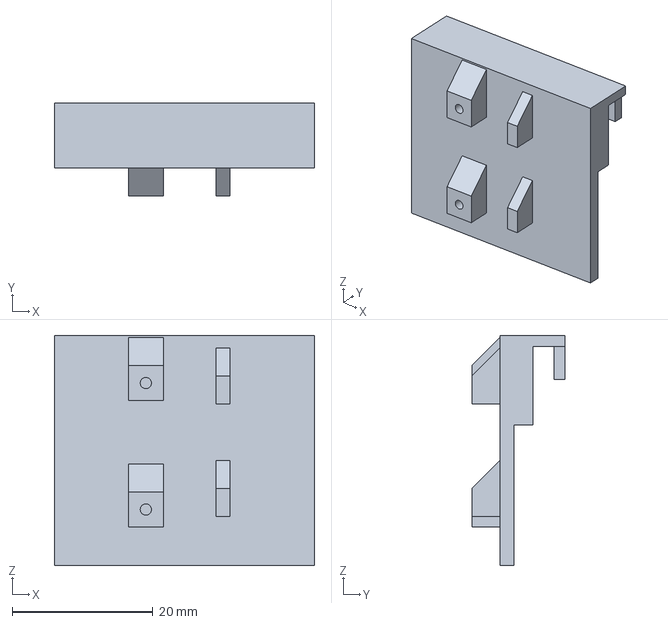
[picture p47: CAD file, 2026-10-26]
hardware/cad/power-sensor-mount/Gladiator_INA_Mount_v3.step
37.0 x 13.3 x 32.8 mm
