iThinkiKhan/Gladiator/hardware/cad/power-tray/PowerBoardTray_v5.step

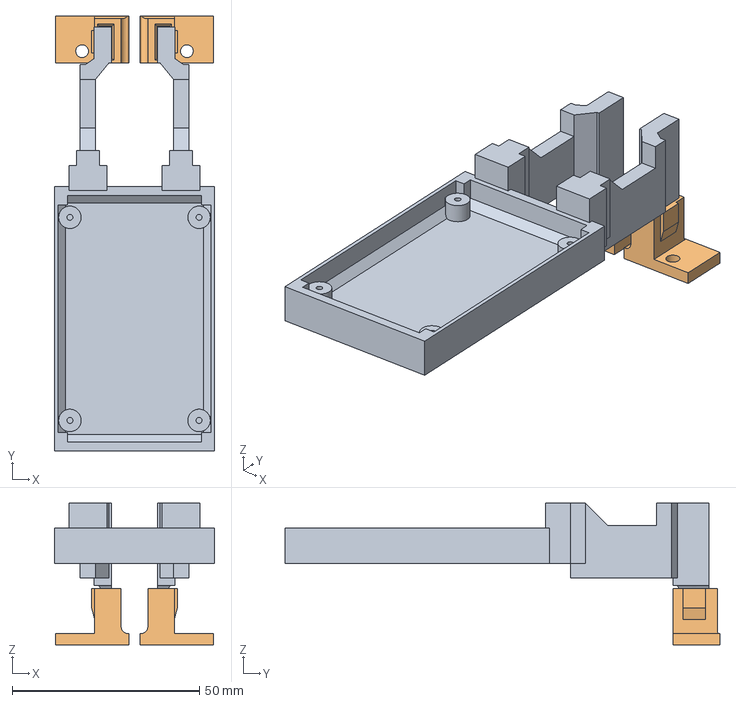
[picture p48: CAD file, 2026-10-26]
hardware/cad/power-tray/PowerBoardTray_v5.step
42.8 x 116.2 x 37.8 mm
