iThinkiKhan/Gladiator/hardware/cad/power-tray/stl/Gladiator_PowerTray_v5_BaseLeft_print-tab-down.stl

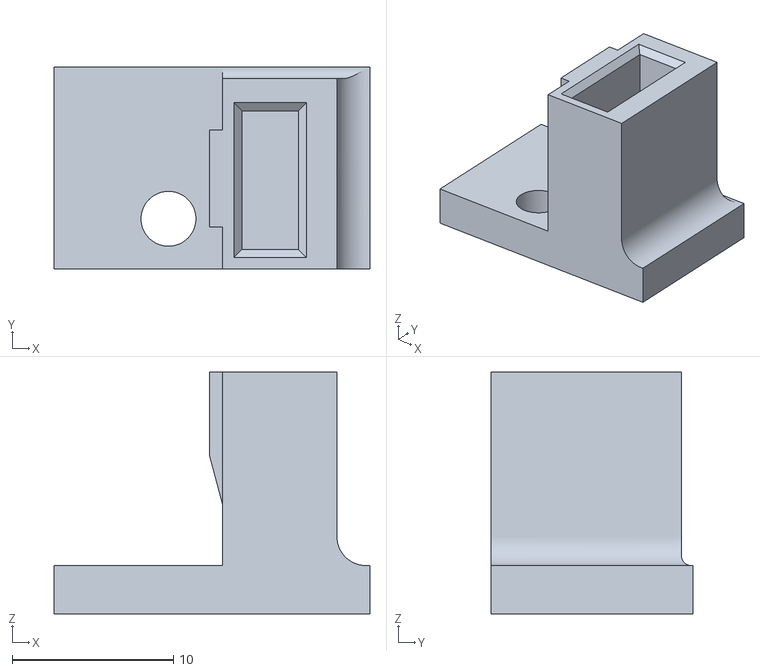
[picture p49: CAD file, 2026-10-26]
hardware/cad/power-tray/stl/Gladiator_PowerTray_v5_BaseLeft_print-tab-down.stl
19.6 x 12.5 x 15.0
