iThinkiKhan/Gladiator/hardware/cad/rails/Gladiator_Arch_Rail_Left_v4.stl

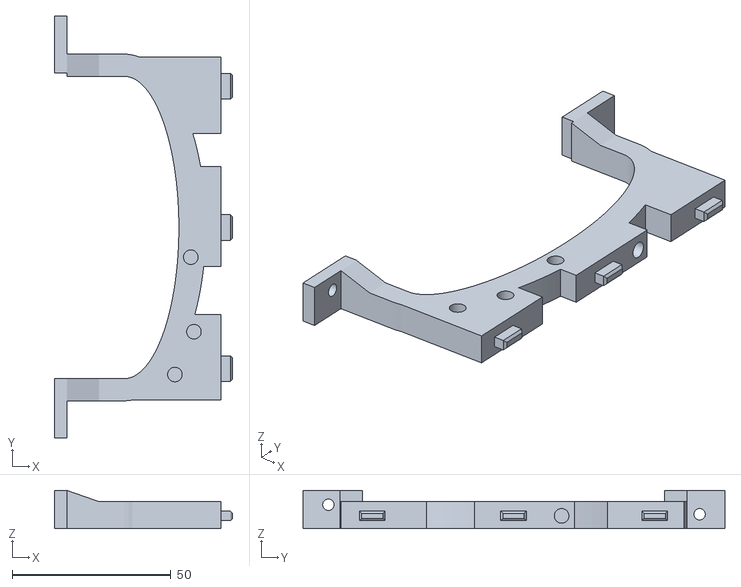
[picture p50: CAD file, 2026-10-26]
hardware/cad/rails/Gladiator_Arch_Rail_Left_v4.stl
56.2 x 133.0 x 12.0
