iThinkiKhan/Gladiator/hardware/cad/shield-emblems/Emblem_Cradle.stl

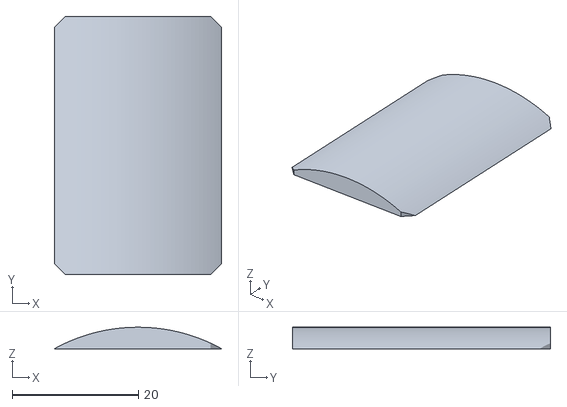
[picture p51: CAD file, 2026-10-26]
hardware/cad/shield-emblems/Emblem_Cradle.stl
26.5 x 40.8 x 3.41
