iThinkiKhan/Gladiator/hardware/cad/speaker-mount/Gladiator_Speaker_Rail_Bracket_v1.step

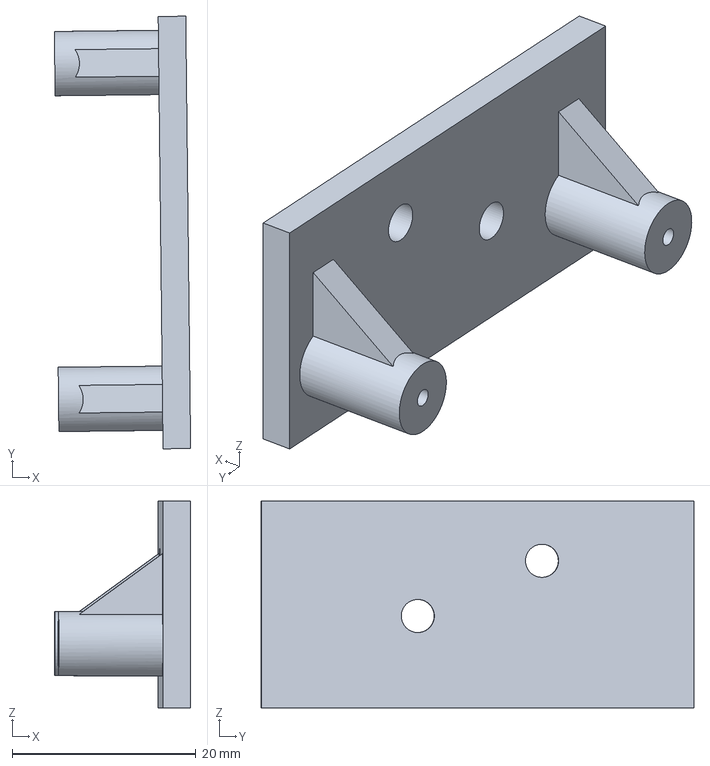
[picture p52: CAD file, 2026-10-26]
hardware/cad/speaker-mount/Gladiator_Speaker_Rail_Bracket_v1.step
14.8 x 47.0 x 22.5 mm
