iThinkiKhan/Gladiator/hardware/cad/switch-holder/Gladiator_SwitchHolder_v3.step

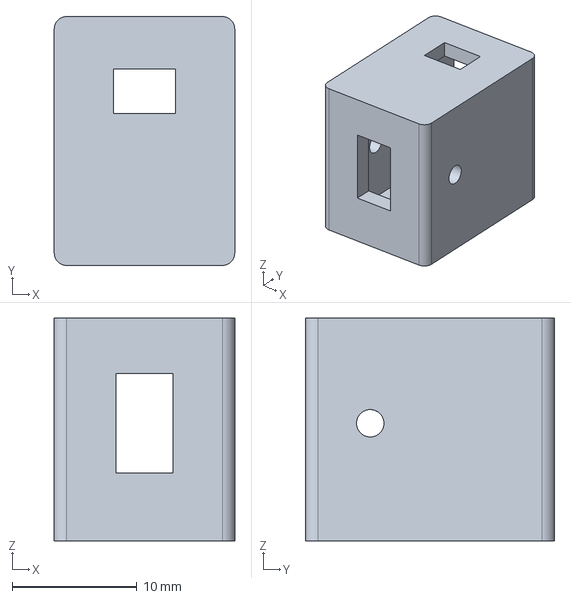
[picture p53: CAD file, 2026-10-26]
hardware/cad/switch-holder/Gladiator_SwitchHolder_v3.step
14.5 x 20.0 x 17.9 mm
