iThinkiKhan/Gladiator/hardware/cad/upper-deck/Gladiator_UpperDeck_v4.step

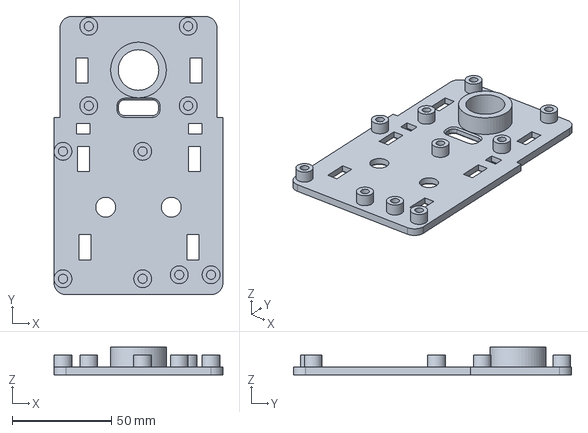
[picture p54: CAD file, 2026-10-26]
hardware/cad/upper-deck/Gladiator_UpperDeck_v4.step
85.0 x 140.0 x 14.0 mm
