iThinkiKhan/Gladiator/hardware/cad/body-shell/Gladiator_Round5_Print.FCStd

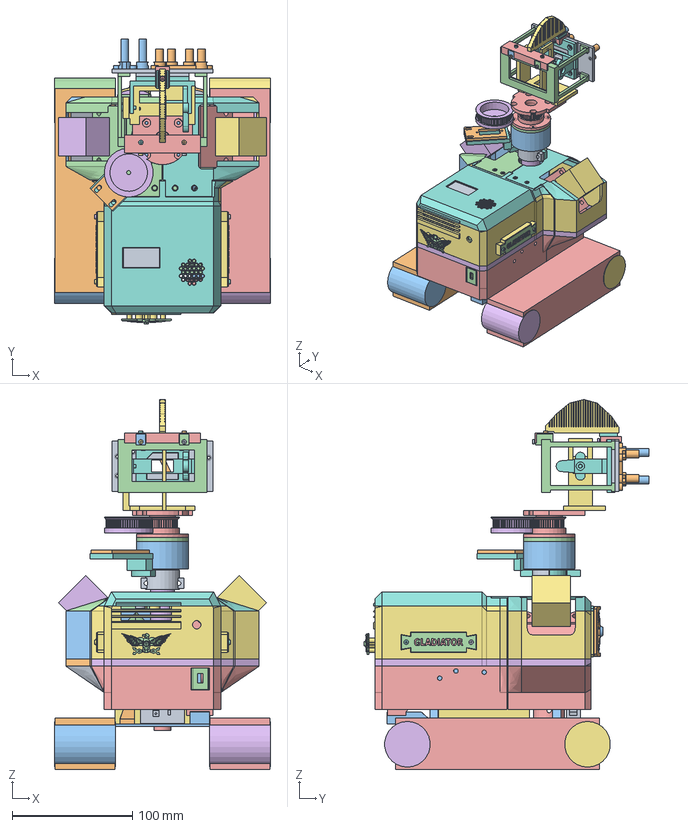
[picture p55: CAD file, 2026-10-26]
hardware/cad/body-shell/Gladiator_Round5_Print.FCStd
180.0 x 237.0 x 308.0 mm
Lens_Plate
Tablet_L
Letters_L
Tablet_R
Letters_R
Scutum_Field_L
Scutum_Emblem_L
Scutum_Boss_L
Scutum_Field_R
Scutum_Emblem_R
Scutum_Boss_R
Aquila_Relief
Crest_Clamp
Crest_Clamp_Shoe
Galea_Crest
Crest_Holder_Trim
Neck_Clamp_Shoe_21_5
Neck_Clamp_Shoe_57_5
Neck_Clamp_0
Neck_Clamp_1
Neck_Guard
Tablet_L_M2_0
Tablet_L_M2_1
Tablet_R_M2_0
Tablet_R_M2_1
Scutum_L_M2
Scutum_R_M2
Aquila_Centre_M2
Crest_Top_M2
Crest_Clamp_M2
Neck_Clamp_M2_21_5
Neck_Guard_M2_21_5
Neck_Clamp_M2_57_5
Neck_Guard_M2_57_5
Ref_ChassisDeck
Ref_UpperDeck
Ref_MastBase
Ref_MastTube
Ref_BatteryBox
Ref_BatteryCells
Ref_Breadboard
Ref_DrvV5_Base_L
Ref_DrvV5_Base_R
Ref_DrvV5_Wedge_L
Ref_DrvV5_Wedge_R
Ref_DrvV5_Fins_L
Ref_DrvV5_Fins_R
Ref_BaseLeft
Ref_BaseRight
Track_Approx
Wheel_Approx
Wheel_Approx001
Track_Approx001
Wheel_Approx002
Wheel_Approx003
Head_Neck_Main
Head_Neck_Clamp_Cap
Head_Pan_Servo_Carriage
Head_Pan_Rotor
Head_Pan_Retainer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
