iThinkiKhan/Gladiator/hardware/cad/body-shell/stl/Aquila_Relief.stl

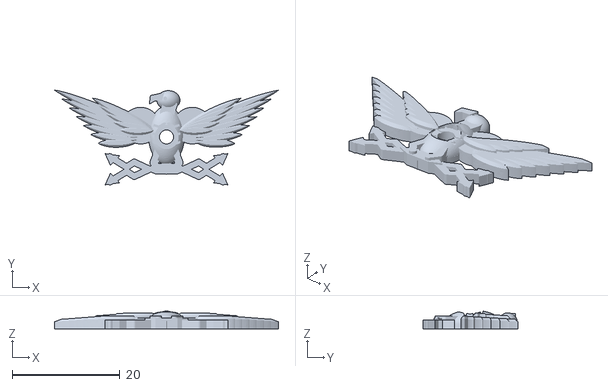
[picture p56: CAD file, 2026-10-26]
hardware/cad/body-shell/stl/Aquila_Relief.stl
41.6 x 17.6 x 3.32
