iThinkiKhan/Gladiator/hardware/cad/camera-mount/Gladiator_Camera_Service_v2_REVIEW.FCStd

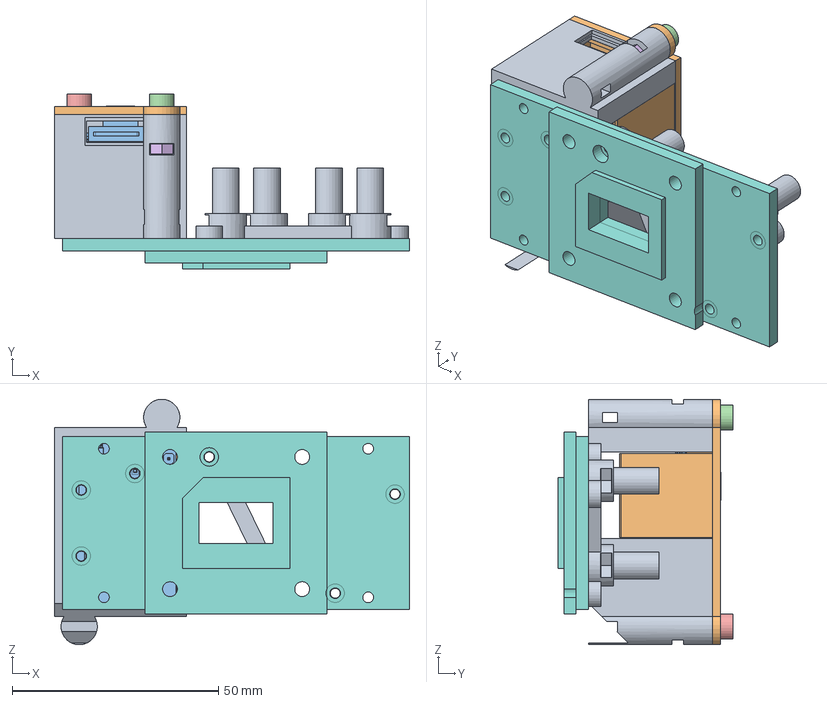
[picture p57: CAD file, 2026-10-26]
hardware/cad/camera-mount/Gladiator_Camera_Service_v2_REVIEW.FCStd
86.0 x 42.4 x 59.4 mm
Mount_Tray
Screw_Cover
ESP32_CAM_measured_reference
M3x12_screw_0
M3x12_screw_1
M3_nut_0
M3_nut_1
GH44_Dual_Carrier
ToF_Sensor_Frame
