iThinkiKhan/Gladiator/hardware/cad/camera-mount/stl/Camera_Service_v2_Tray.stl

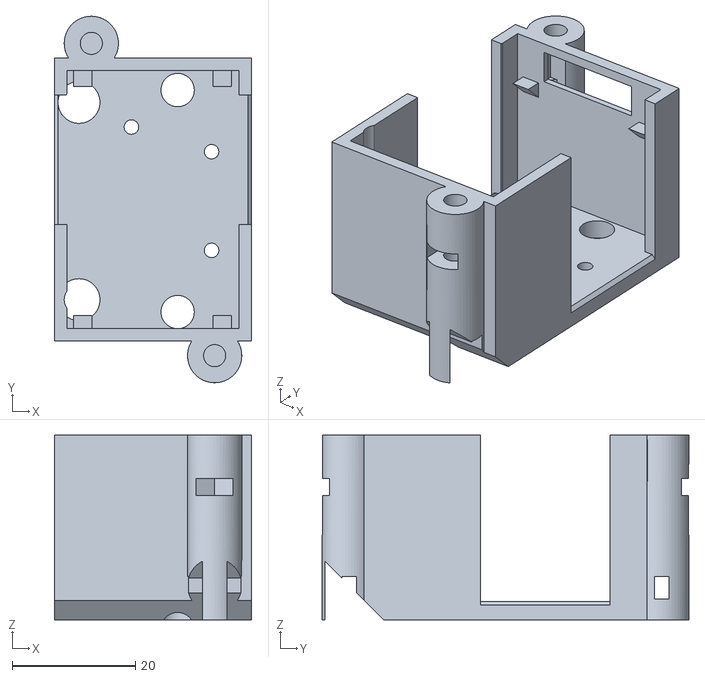
[picture p58: CAD file, 2026-10-26]
hardware/cad/camera-mount/stl/Camera_Service_v2_Tray.stl
32.0 x 59.5 x 30.0
