iThinkiKhan/Gladiator/hardware/cad/head-parts/stl/Gladiator_Head_v05_Pan_Raised_Pedestal.stl

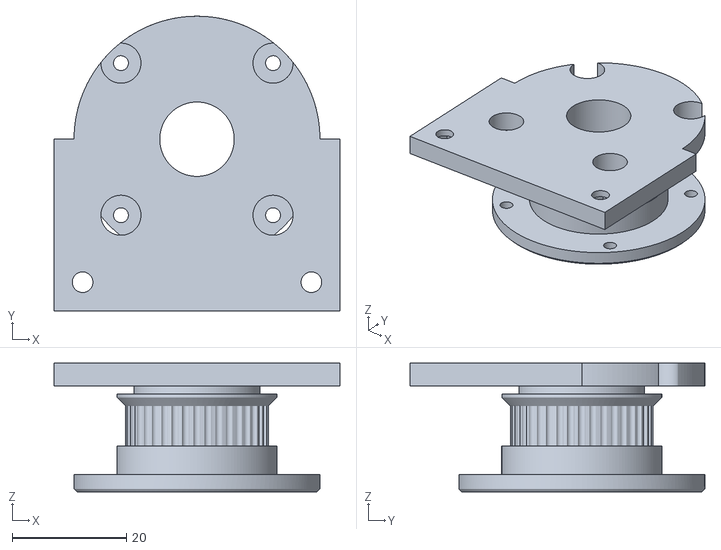
[picture p59: CAD file, 2026-10-26]
hardware/cad/head-parts/stl/Gladiator_Head_v05_Pan_Raised_Pedestal.stl
50.0 x 51.5 x 22.5
