iThinkiKhan/Gladiator/hardware/cad/mast-base/Gladiator_Master_MastBase_short-spigot.FCStd

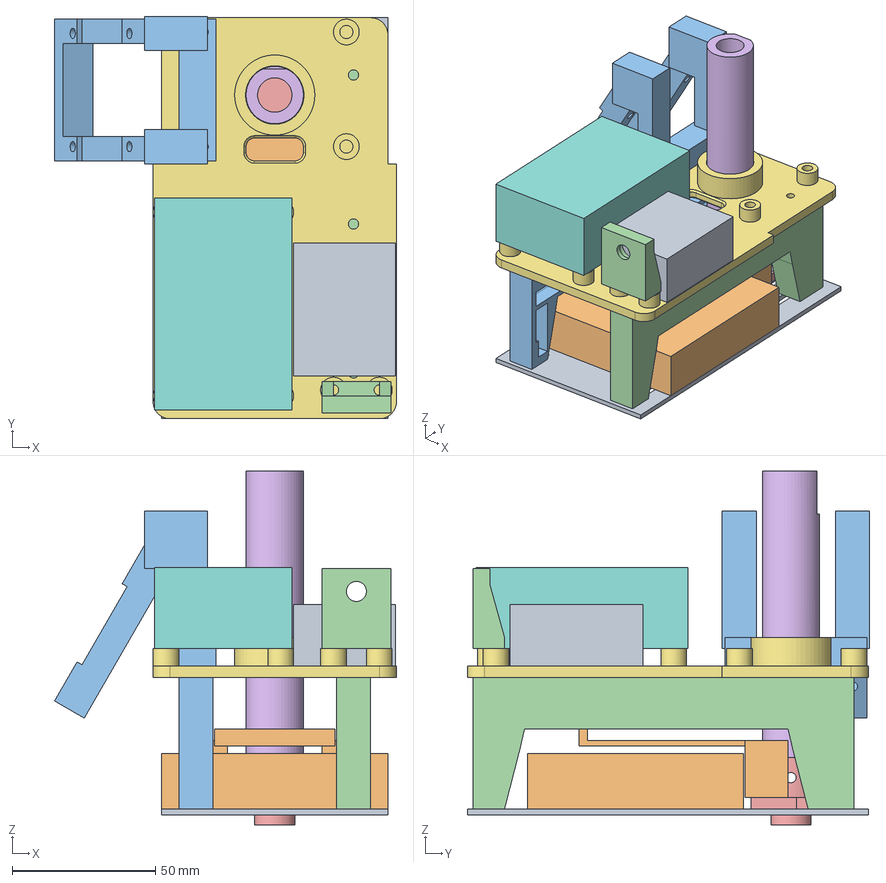
[picture p60: CAD file, 2026-10-26]
hardware/cad/mast-base/Gladiator_Master_MastBase_short-spigot.FCStd
119.4 x 140.5 x 123.5 mm
Chassis deck
Battery box (reference, empty)
Side rail, left
Side rail, right
Mast base
Mast tube
Upper deck
S3 + expander (reference envelope)
Breadboard + C6 + BNO (reference envelope)
Power board shield
Driver mount, left
Antenna bulkhead mount
