iThinkiKhan/Gladiator/hardware/cad/motor-driver-mounts/stl/Base_Left.stl

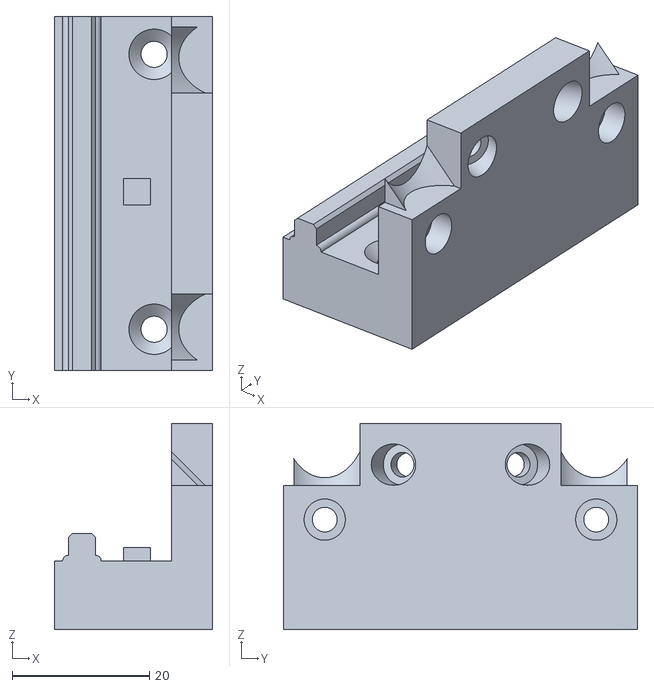
[picture p61: CAD file, 2026-10-26]
hardware/cad/motor-driver-mounts/stl/Base_Left.stl
23.0 x 51.5 x 30.0
