iThinkiKhan/Gladiator/hardware/cad/power-tray/stl/PowerBoardTray_v5_installed.stl

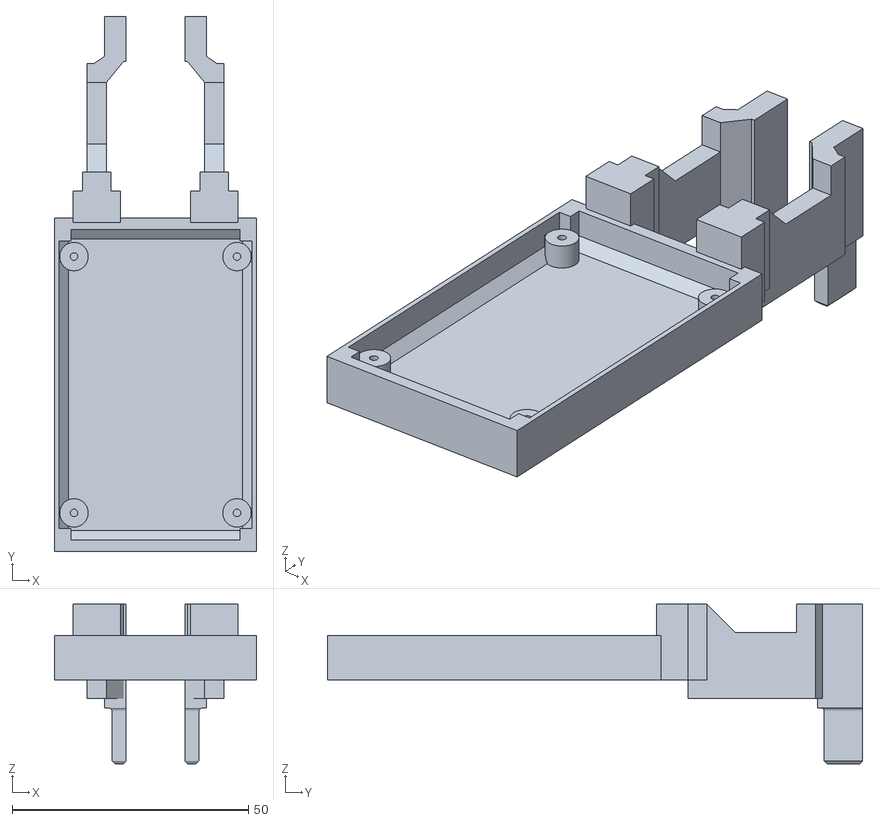
[picture p62: CAD file, 2026-10-26]
hardware/cad/power-tray/stl/PowerBoardTray_v5_installed.stl
42.8 x 113.2 x 33.8
