iThinkiKhan/Gladiator/hardware/cad/rails/Gladiator_Arch_Rail_Right_v4.stl

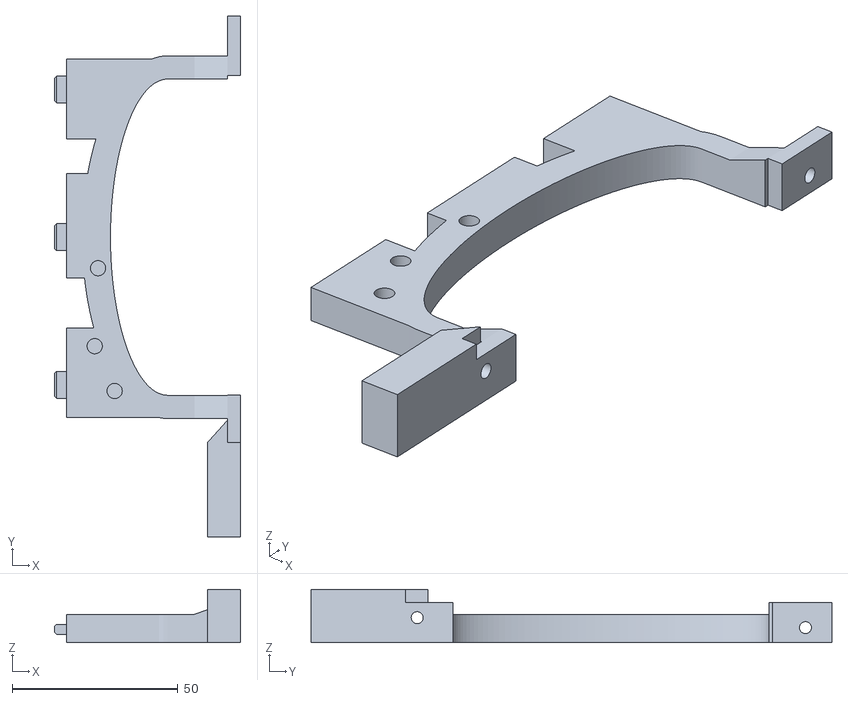
[picture p63: CAD file, 2026-10-26]
hardware/cad/rails/Gladiator_Arch_Rail_Right_v4.stl
56.2 x 157.0 x 16.0
