iThinkiKhan/Gladiator/hardware/cad/shield-emblems/Scutum_Emblem_v2.FCStd

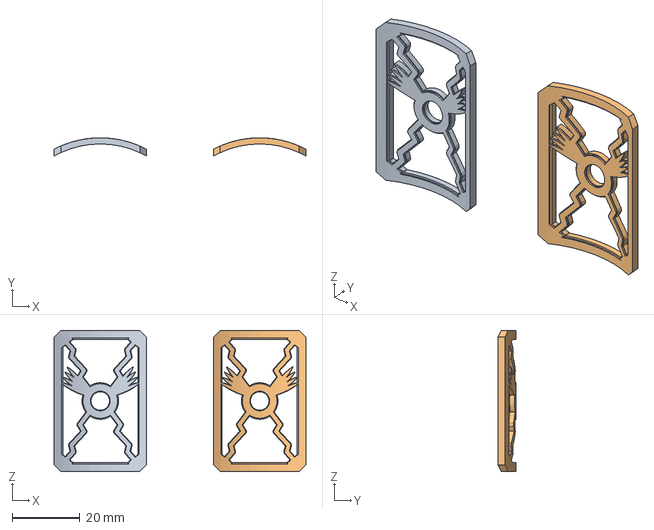
[picture p64: CAD file, 2026-10-26]
hardware/cad/shield-emblems/Scutum_Emblem_v2.FCStd
74.3 x 5.41 x 41.6 mm
Scutum_Emblem_v2_L
Scutum_Emblem_v2_R
