iThinkiKhan/Gladiator/hardware/cad/body-shell/stl/Neck_Clamp_1.stl

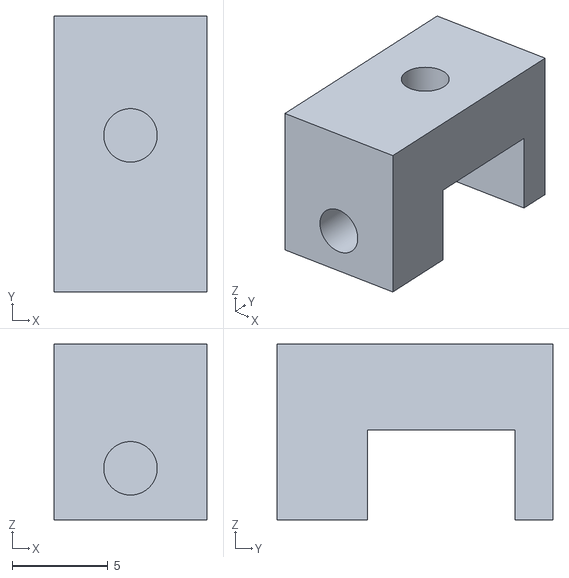
[picture p65: CAD file, 2026-10-26]
hardware/cad/body-shell/stl/Neck_Clamp_1.stl
8.00 x 14.4 x 9.20
