iThinkiKhan/Gladiator/hardware/cad/head-parts/stl/Gladiator_Head_v05_Radar_Sensor_Frame.stl

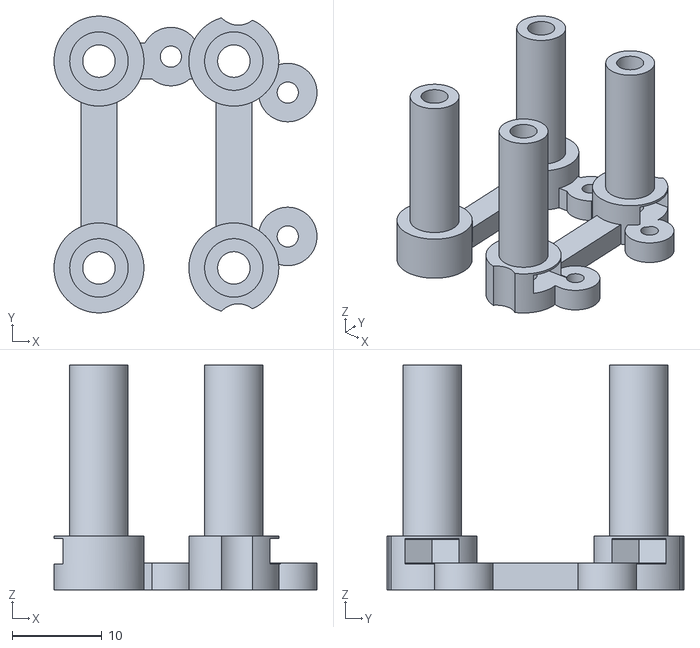
[picture p66: CAD file, 2026-10-26]
hardware/cad/head-parts/stl/Gladiator_Head_v05_Radar_Sensor_Frame.stl
29.2 x 33.0 x 25.0
