iThinkiKhan/Gladiator/hardware/cad/power-tray/stl/Gladiator_PowerTray_v5_FitCoupon_base-and-peg.stl

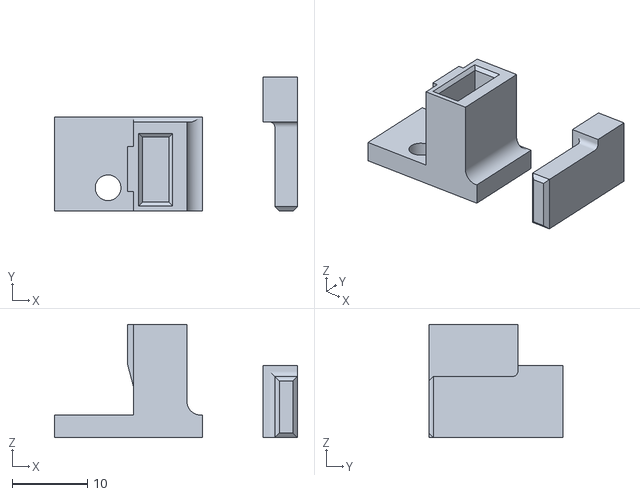
[picture p67: CAD file, 2026-10-26]
hardware/cad/power-tray/stl/Gladiator_PowerTray_v5_FitCoupon_base-and-peg.stl
32.2 x 17.8 x 15.0
