iThinkiKhan/Gladiator/hardware/cad/rails/Gladiator_ArchRails_v4.step

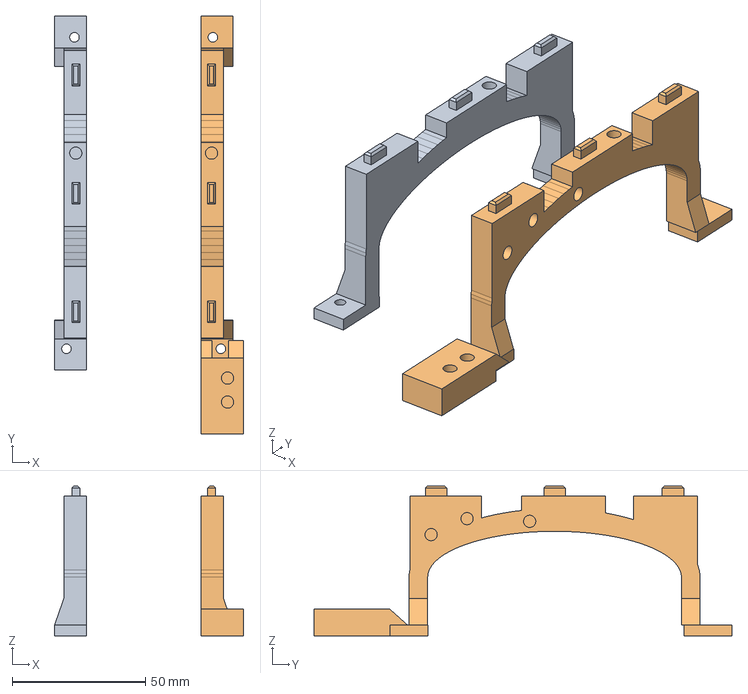
[picture p68: CAD file, 2026-10-26]
hardware/cad/rails/Gladiator_ArchRails_v4.step
71.0 x 157.0 x 56.2 mm
