iThinkiKhan/Gladiator/hardware/cad/body-shell/stl/Tablet_L.stl

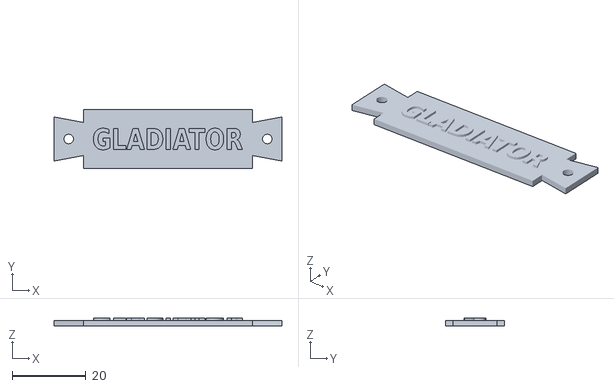
[picture p69: CAD file, 2026-10-26]
hardware/cad/body-shell/stl/Tablet_L.stl
62.0 x 16.0 x 2.10
