iThinkiKhan/Gladiator/hardware/cad/body-shell/stl/Crest_Clamp_Shoe.stl

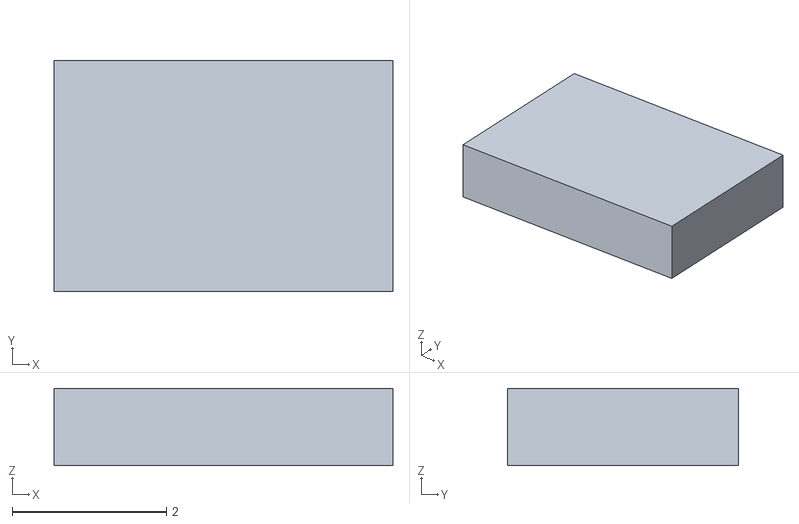
[picture p70: CAD file, 2026-10-26]
hardware/cad/body-shell/stl/Crest_Clamp_Shoe.stl
4.40 x 3.00 x 1.00
