iThinkiKhan/Gladiator/hardware/cad/head-parts/stl/Gladiator_Head_v05_Tilt_Yoke.stl

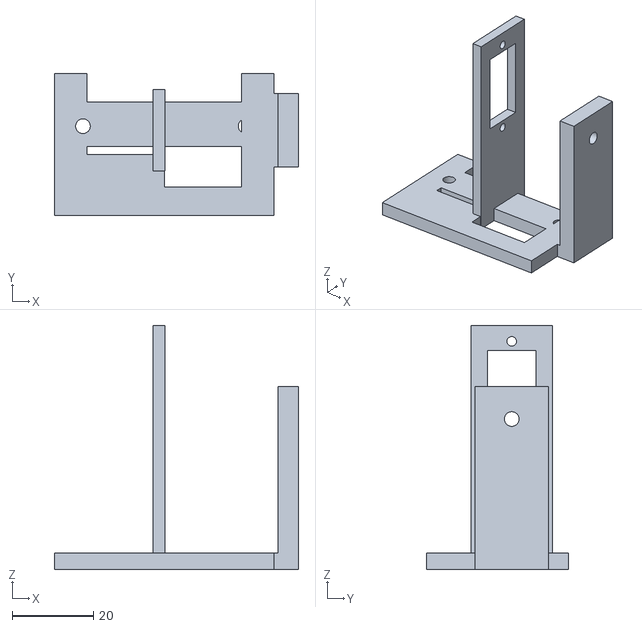
[picture p71: CAD file, 2026-10-26]
hardware/cad/head-parts/stl/Gladiator_Head_v05_Tilt_Yoke.stl
60.0 x 35.0 x 60.0
