iThinkiKhan/Gladiator/hardware/cad/body-shell/stl/Crest_Clamp.stl

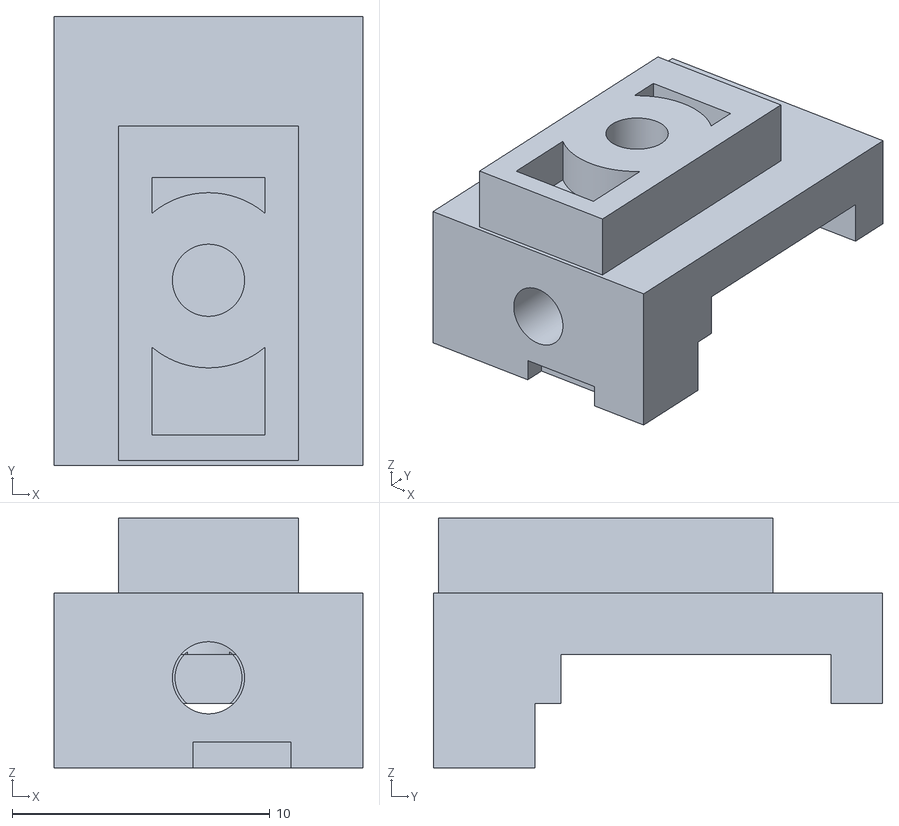
[picture p72: CAD file, 2026-10-26]
hardware/cad/body-shell/stl/Crest_Clamp.stl
12.0 x 17.4 x 9.70
