iThinkiKhan/Gladiator/hardware/cad/head-parts/stl/Gladiator_Head_v05_Pan_Retainer.stl

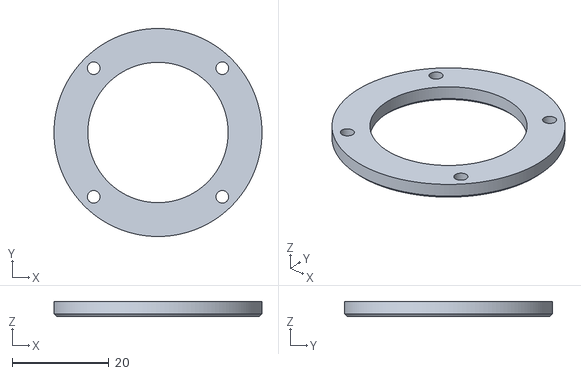
[picture p73: CAD file, 2026-10-26]
hardware/cad/head-parts/stl/Gladiator_Head_v05_Pan_Retainer.stl
43.0 x 43.0 x 3.00
