iThinkiKhan/Gladiator/hardware/cad/body-shell/stl/Galea_Crest.stl

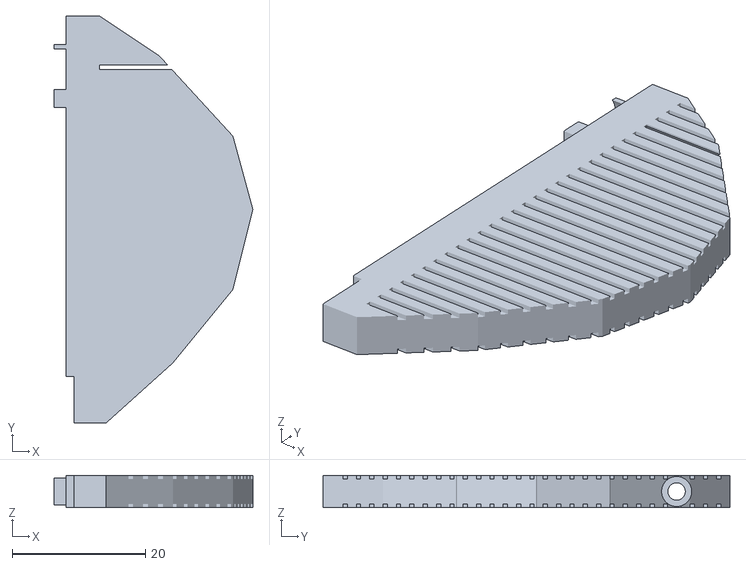
[picture p74: CAD file, 2026-10-26]
hardware/cad/body-shell/stl/Galea_Crest.stl
29.8 x 61.0 x 4.80
