iThinkiKhan/Gladiator/hardware/cad/head-parts/stl/Gladiator_Head_v05_Pan_Drive_Pulley.stl

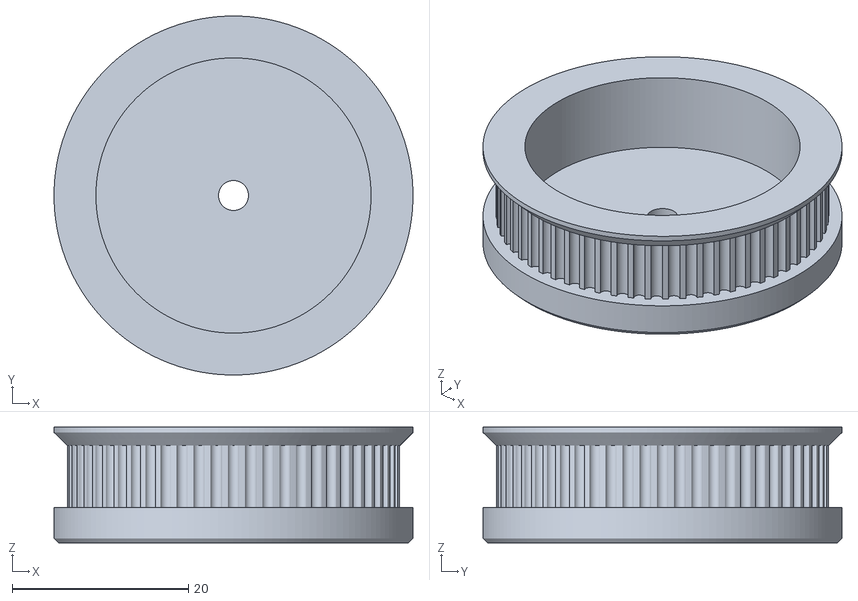
[picture p75: CAD file, 2026-10-26]
hardware/cad/head-parts/stl/Gladiator_Head_v05_Pan_Drive_Pulley.stl
40.7 x 40.7 x 13.1
