iThinkiKhan/Gladiator/hardware/cad/body-shell/stl/Neck_Clamp_Shoe_21_5.stl

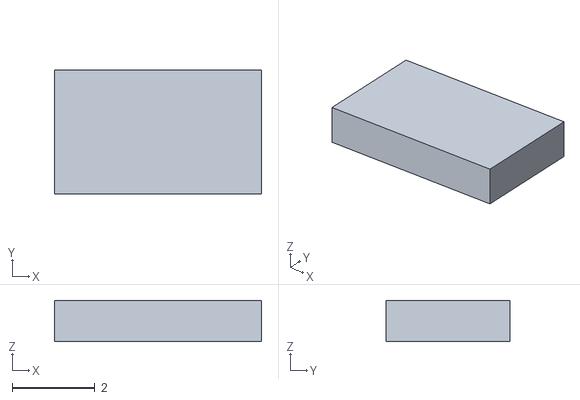
[picture p76: CAD file, 2026-10-26]
hardware/cad/body-shell/stl/Neck_Clamp_Shoe_21_5.stl
5.00 x 3.00 x 1.00
