iThinkiKhan/Gladiator/hardware/cad/head-parts/stl/Gladiator_Head_v05_Neck_Clamp_Cap.stl

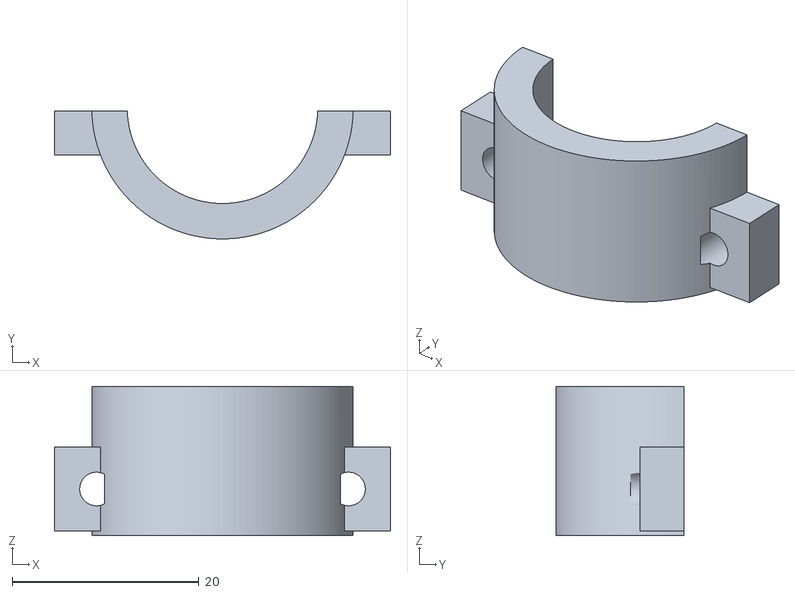
[picture p77: CAD file, 2026-10-26]
hardware/cad/head-parts/stl/Gladiator_Head_v05_Neck_Clamp_Cap.stl
36.0 x 13.7 x 16.0
