iThinkiKhan/Gladiator/hardware/cad/body-shell/stl/Scutum_Boss_L.stl

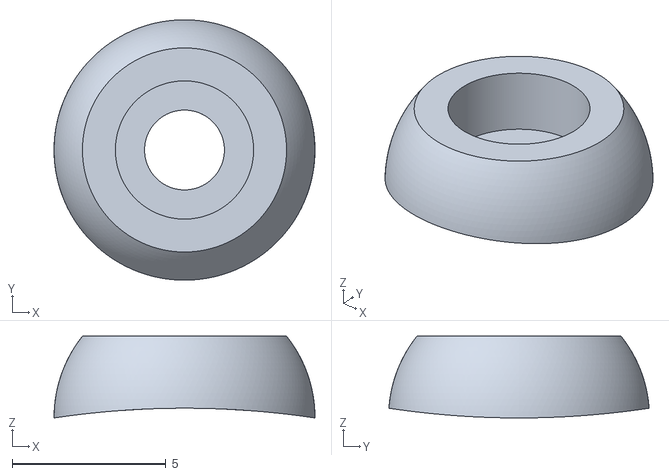
[picture p78: CAD file, 2026-10-26]
hardware/cad/body-shell/stl/Scutum_Boss_L.stl
8.50 x 8.48 x 2.67
