iThinkiKhan/Gladiator/hardware/cad/head-parts/stl/Gladiator_Head_v05_Rear_Display_Frame.stl

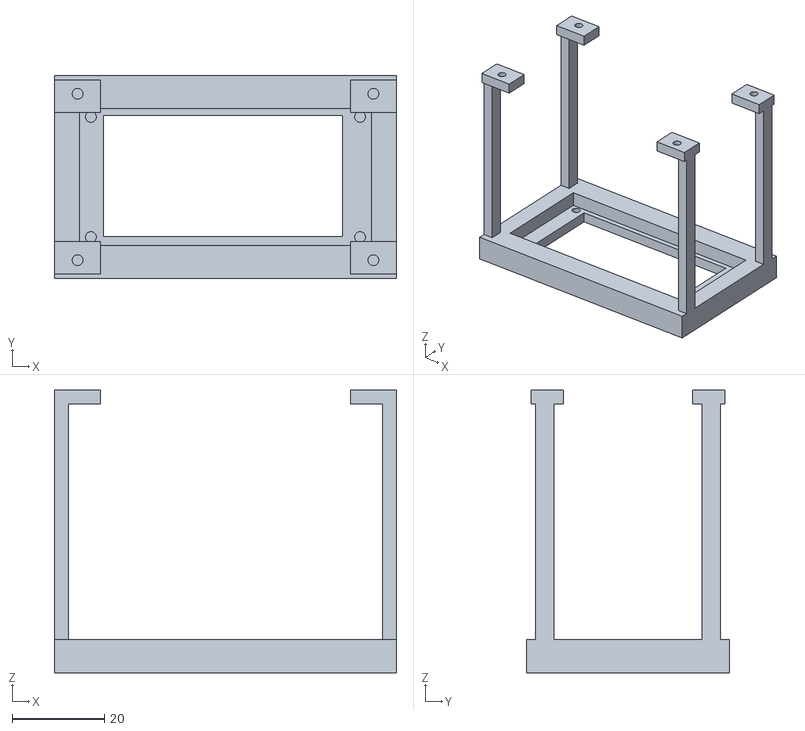
[picture p79: CAD file, 2026-10-26]
hardware/cad/head-parts/stl/Gladiator_Head_v05_Rear_Display_Frame.stl
74.0 x 44.0 x 61.2
