iThinkiKhan/Gladiator/hardware/cad/body-shell/stl/Rear_Hood.stl

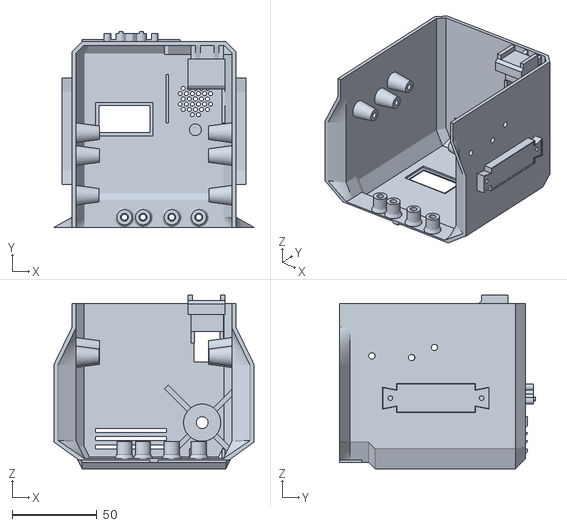
[picture p80: CAD file, 2026-10-26]
hardware/cad/body-shell/stl/Rear_Hood.stl
118.3 x 115.8 x 102.9
