iThinkiKhan/Gladiator/hardware/cad/head-parts/stl/Gladiator_Head_v05_GH44_Tilt_Receiver.stl

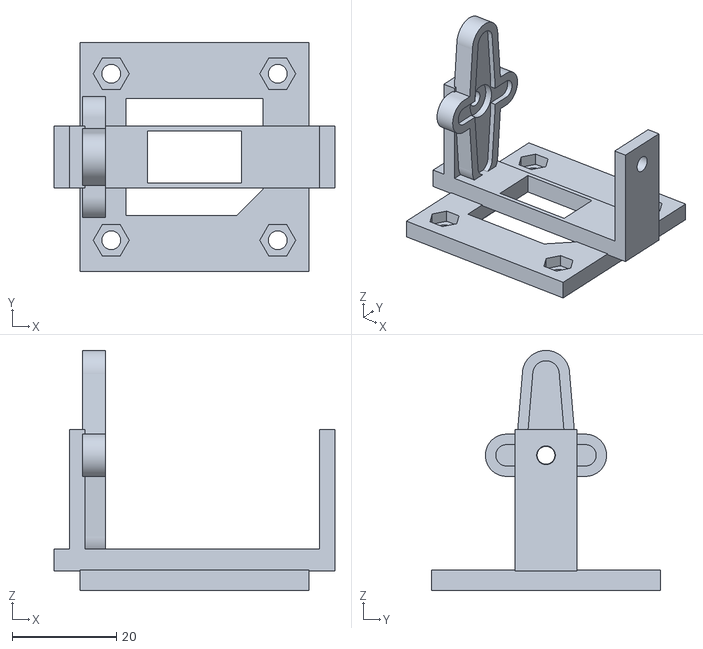
[picture p81: CAD file, 2026-10-26]
hardware/cad/head-parts/stl/Gladiator_Head_v05_GH44_Tilt_Receiver.stl
54.0 x 44.0 x 46.2
