iThinkiKhan/Gladiator/hardware/cad/head-parts/stl/Gladiator_Head_v05_Pan_Rotor.stl

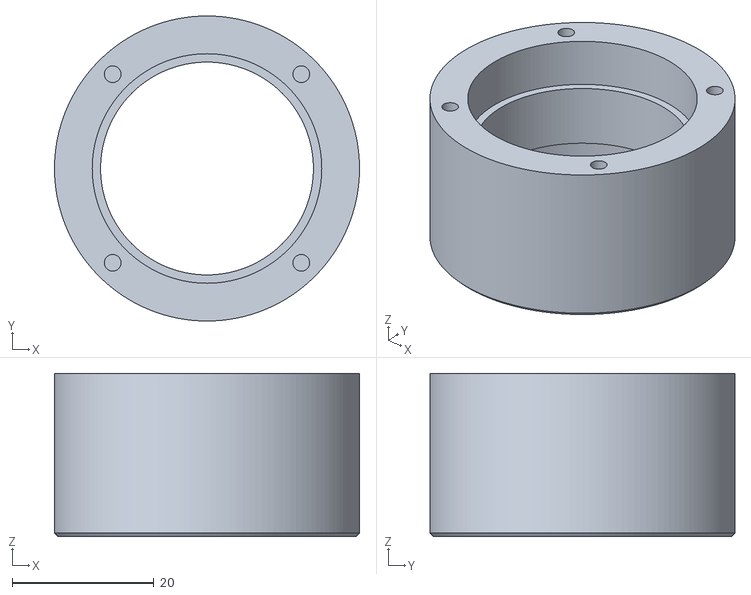
[picture p82: CAD file, 2026-10-26]
hardware/cad/head-parts/stl/Gladiator_Head_v05_Pan_Rotor.stl
43.0 x 43.0 x 23.0
