iThinkiKhan/Gladiator/hardware/cad/head-parts/stl/Gladiator_Head_v05_Pan_Servo_Carriage.stl

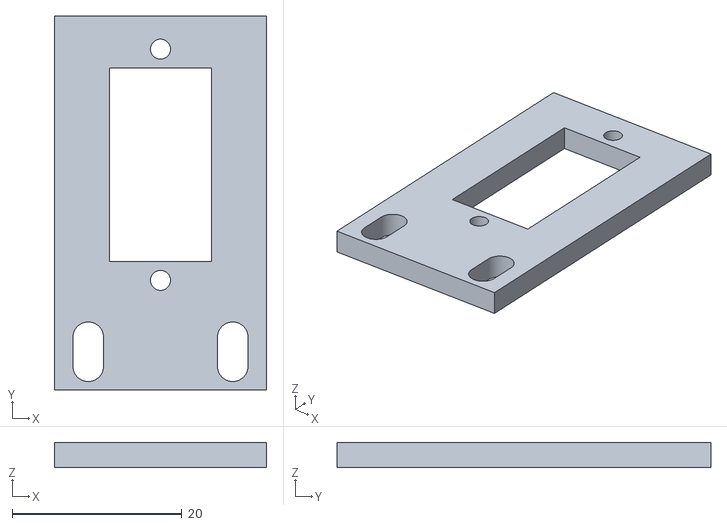
[picture p83: CAD file, 2026-10-26]
hardware/cad/head-parts/stl/Gladiator_Head_v05_Pan_Servo_Carriage.stl
25.0 x 44.0 x 3.00
