iThinkiKhan/Gladiator/hardware/cad/body-shell/stl/Crest_Holder_Trim.stl

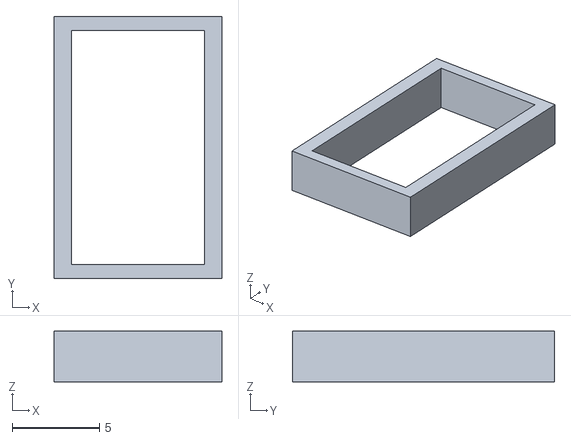
[picture p84: CAD file, 2026-10-26]
hardware/cad/body-shell/stl/Crest_Holder_Trim.stl
9.60 x 15.0 x 2.90
