iThinkiKhan/Gladiator/hardware/cad/head-parts/stl/Gladiator_Head_v05_GH44_Dual_Carrier.stl

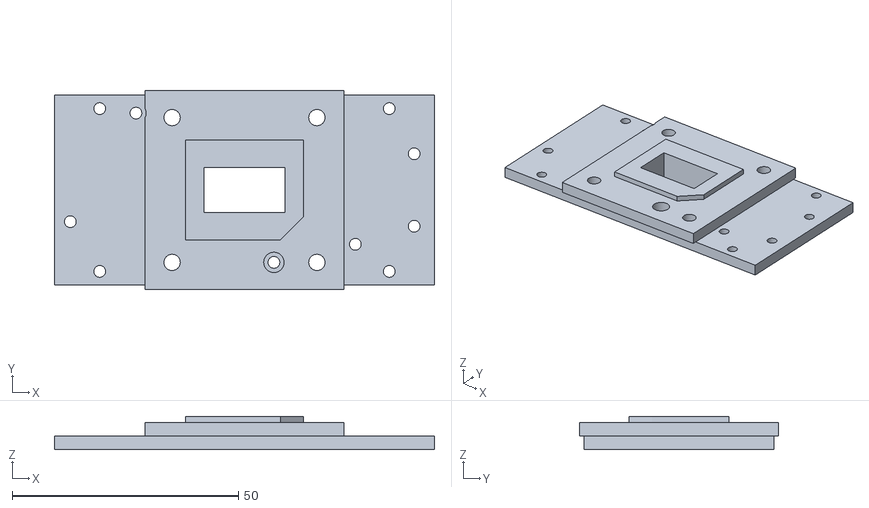
[picture p85: CAD file, 2026-10-26]
hardware/cad/head-parts/stl/Gladiator_Head_v05_GH44_Dual_Carrier.stl
84.0 x 44.0 x 7.40
