iThinkiKhan/Gladiator/hardware/cad/body-shell/stl/Lens_Plate.stl

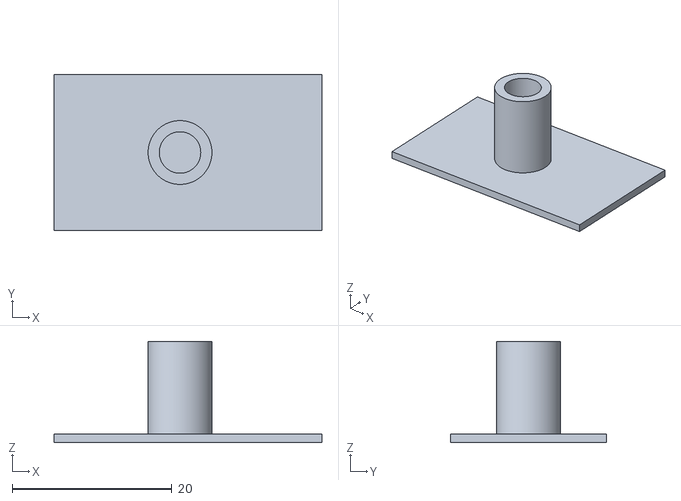
[picture p86: CAD file, 2026-10-26]
hardware/cad/body-shell/stl/Lens_Plate.stl
33.6 x 19.6 x 12.7
