iThinkiKhan/Gladiator/hardware/cad/body-shell/stl/Neck_Guard.stl

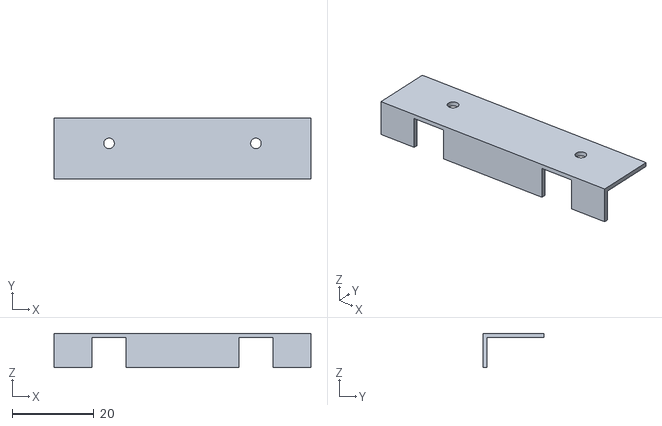
[picture p87: CAD file, 2026-10-26]
hardware/cad/body-shell/stl/Neck_Guard.stl
63.0 x 14.9 x 8.40
