iThinkiKhan/Gladiator/hardware/cad/body-shell/stl/Scutum_Field_R.stl

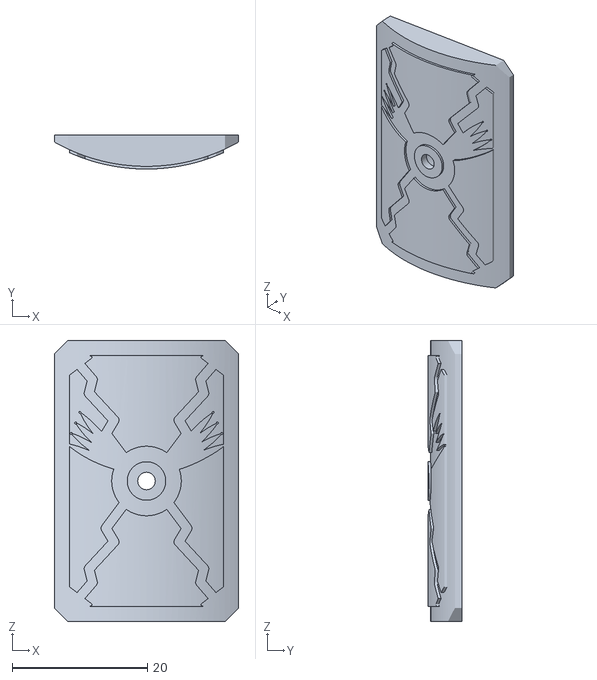
[picture p88: CAD file, 2026-10-26]
hardware/cad/body-shell/stl/Scutum_Field_R.stl
27.3 x 5.05 x 41.6
