iThinkiKhan/Gladiator/(list of files, cad)

Other CAD files:
hardware/cad/power-tray/stl/Gladiator_PowerTray_v5_print-on-rear-face.stl
hardware/cad/power-tray/stl/Gladiator_PowerTray_v5_BaseRight_print-tab-down.stl
hardware/cad/body-shell/stl/Front_Left.stl
hardware/cad/body-shell/stl/Neck_Clamp_0.stl
hardware/cad/antenna-pylon/Gladiator_AntennaPylon_v3.FCStd
hardware/cad/antenna-pylon/Gladiator_AntennaPylon_v3.stl
hardware/cad/chassis/Gladiator_Master.FCStd
hardware/cad/head-assembly/Gladiator_Head_Master.FCStd
hardware/cad/head-parts/Gladiator_Head_v05_PanStack.FCStd
hardware/cad/insert-fit-coupon/M2_D3_L3_Coupon.FCStd
hardware/cad/insert-fit-coupon/M2_D3_L3_Coupon.stl
hardware/cad/motor-driver-mounts/DriverMount_v5.FCStd
hardware/cad/power-sensor-mount/Gladiator_INA_Mount_v3.FCStd
hardware/cad/power-sensor-mount/Gladiator_INA_Mount_v3.stl
hardware/cad/power-tray/PowerBoardTray_v5.FCStd
hardware/cad/rails/Gladiator_ArchRails_v4.FCStd
hardware/cad/shield-emblems/Scutum_Emblem_v2.stl
hardware/cad/speaker-mount/Gladiator_Speaker_Rail_Bracket_v1.FCStd
hardware/cad/speaker-mount/Gladiator_Speaker_Rail_Bracket_v1.stl
hardware/cad/switch-holder/Gladiator_SwitchHolder_v3.FCStd
hardware/cad/switch-holder/Gladiator_SwitchHolder_v3.stl
hardware/cad/upper-deck/Gladiator_UpperDeck_v4.FCStd
hardware/cad/upper-deck/Gladiator_UpperDeck_v4.stl
