iThinkiKhan/Gladiator/photos/02-chassis-assembly/README.md

# Chassis assembly

<!-- WRITE: Chassis assembly introduction. -->

[All photos](../README.md)

### 20261009_124805.jpg

<!-- WRITE: Caption for 20261009_124805.jpg. -->

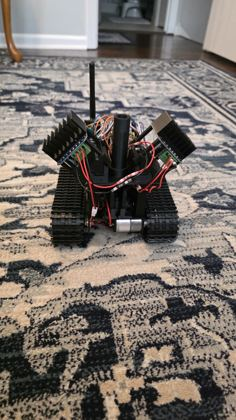
[picture p89: photos/thumbnails/02-chassis-assembly/20261009_124805.jpg]
Chassis assembly — 2026-10-09


### 20261009_124810.jpg

<!-- WRITE: Caption for 20261009_124810.jpg. -->

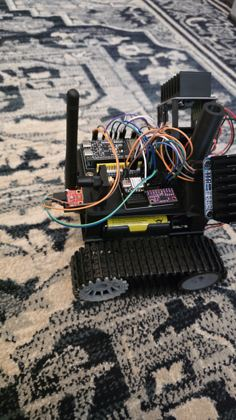
[picture p90: photos/thumbnails/02-chassis-assembly/20261009_124810.jpg]
Chassis assembly — 2026-10-09


### 20261009_124815.jpg

<!-- WRITE: Caption for 20261009_124815.jpg. -->

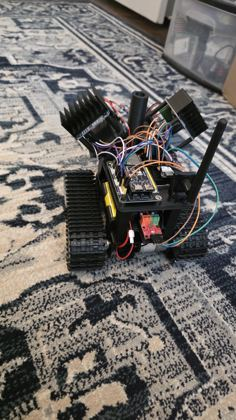
[picture p91: photos/thumbnails/02-chassis-assembly/20261009_124815.jpg]
Chassis assembly — 2026-10-09


### 20261009_124819.jpg

<!-- WRITE: Caption for 20261009_124819.jpg. -->

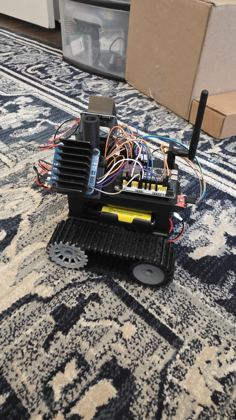
[picture p92: photos/thumbnails/02-chassis-assembly/20261009_124819.jpg]
Chassis assembly — 2026-10-09


### 20261009_124826.jpg

<!-- WRITE: Caption for 20261009_124826.jpg. -->

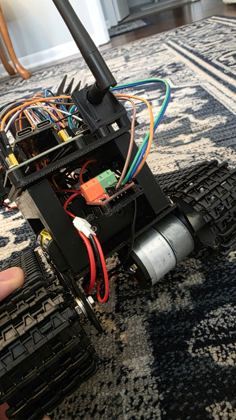
[picture p93: photos/thumbnails/02-chassis-assembly/20261009_124826.jpg]
Chassis assembly — 2026-10-09


### 20261009_124829.jpg

<!-- WRITE: Caption for 20261009_124829.jpg. -->

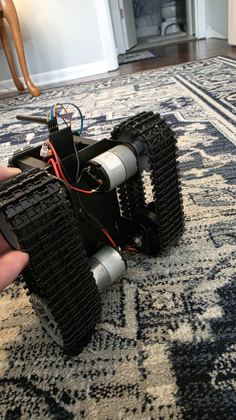
[picture p94: photos/thumbnails/02-chassis-assembly/20261009_124829.jpg]
Chassis assembly — 2026-10-09
