iThinkiKhan/Gladiator/hardware/cad/head-assembly/README.md

# Mast-front head assembly

<!-- WRITE: Mast-front head assembly notes. -->

Viewing assembly; source head prototype v05.

| File | Format |
| --- | --- |
| [Gladiator_Head_Master.FCStd](Gladiator_Head_Master.FCStd) | FCStd |
| [Gladiator_Head_Master.step](Gladiator_Head_Master.step) | step |
| [preview-front.png](preview-front.png) | png |
| [preview-iso.png](preview-iso.png) | png |

Source revision: `head/master` in [gladiator-cad](https://github.com/iThinkiKhan/gladiator-cad/tree/db25f68d589b59520871f2c27f7898625261f611/cad/head/master).

[CAD index](../../README.md)
