iThinkiKhan/Gladiator/hardware/cad/camera-mount/assembled.png

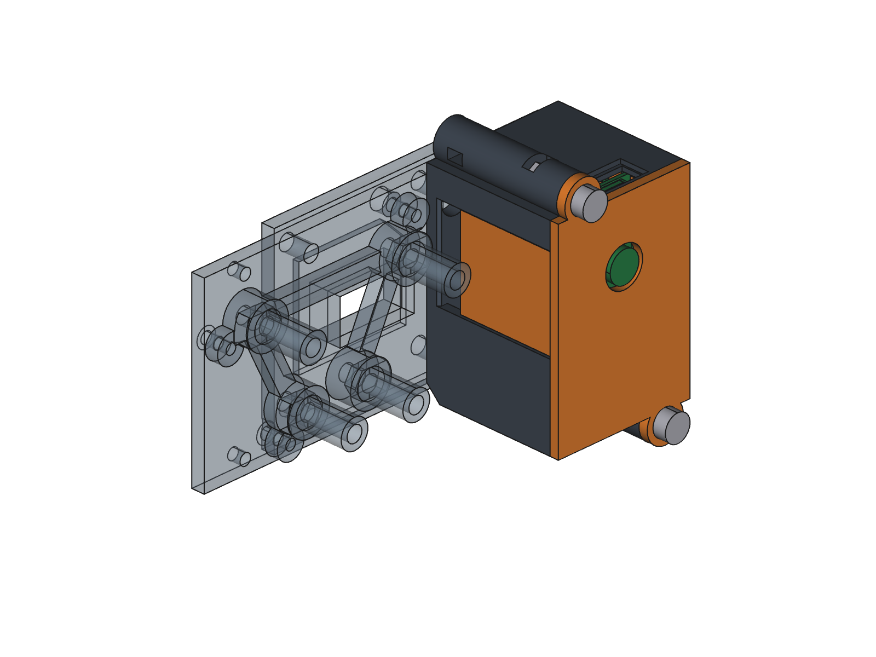
hardware/cad/camera-mount/assembled.png
