iThinkiKhan/Gladiator/hardware/cad/head-assembly/preview-front.png

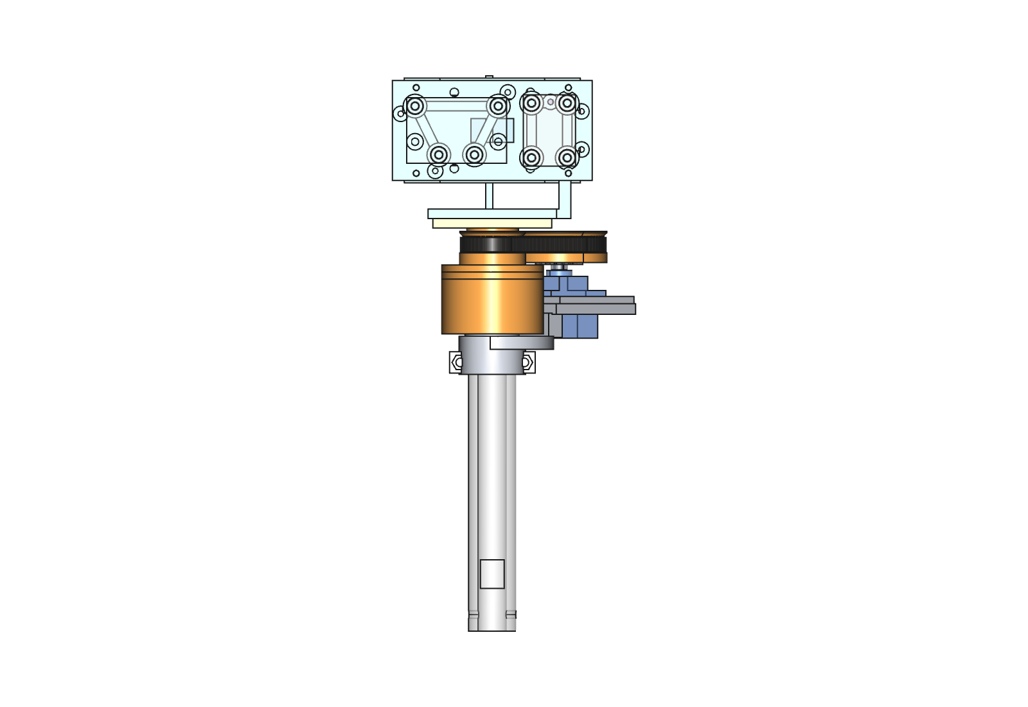
hardware/cad/head-assembly/preview-front.png
