iThinkiKhan/Gladiator/hardware/cad/head-assembly/preview-iso.png

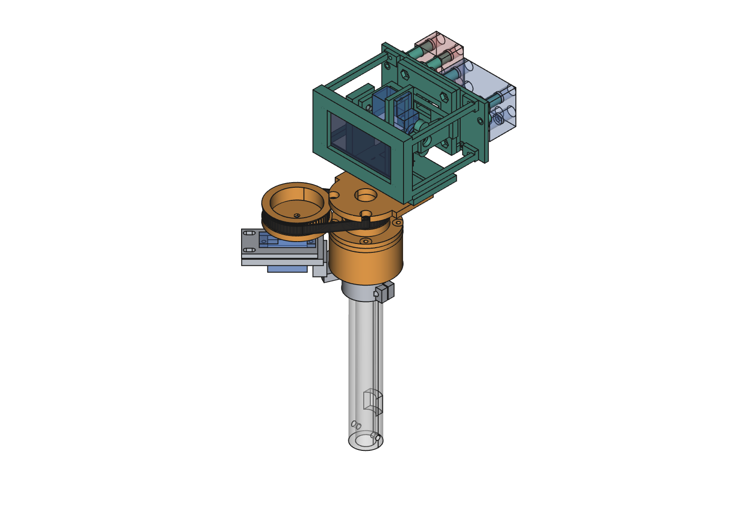
hardware/cad/head-assembly/preview-iso.png
