iThinkiKhan/Gladiator/firmware/tools/hardware-test/index.html

GGLADIATOR V2Hardware setup■ STOP ALLServos off · tracks disarm

Connect Gladiator to begin

Default gateway: 192.168.8.1

Connect to robot

Use a different gateway address

Gateway address

Servos: unknownBattery: unknownTracks: unknown

Nothing moves until you start a test or enable the mast.

Connect to read the calibration stored on this robot.

S3 travel limits: waiting for robot.

Save current entries to robotCopy earlier entries from this device

FIRST TIME SETUP

# Find out which servo is which.

Choose a connection, start a test, then record what moves.

GPIO10 + GPIO13

## A Choose a servo

Servo connectionStarting pulse · µs

Current position is unknown. The first pulse can move the servo immediately.

Test frequency Manual range 500–2575 µs

Frequency · Hz

Temporary manual calibration: override battery lockout for this servo test

Tracks are locked out during an override test. Stop or S3 restart clears the override.

Start servo testStop test

Connect to the robot first.

What happens if I leave this page?

Keep this test active while the page is visible

Leaving or hiding the page requests outputs off. If communication fails, the S3 test lease expires after 10 seconds. Nothing resumes automatically.

## B Position the servo

—µs commanded

Start a servo test to use these controls.

−Step size+

Target pulse · µsMove to target

Window ——

Watch the mechanism. Stop before binding or cable tension. The large readout is the S3-commanded pulse, not position feedback. The target is shown separately.

If a servo stays at an end stop

If the S3-commanded pulse changes but the servo stays pegged, stop the test and check the signal at its connector. Tilt is on GPIO13. At 50 Hz, a 1500 µs command should produce a 1.5 ms high pulse every 20 ms. Software readback cannot confirm the electrical waveform or shaft position.

## C Remember a position

Record the latest commanded pulse, during a test or after stopping. Each recording saves directly to flash on the robot.

No pulse command recorded yet.

This is pan · save centerThis is tilt · save center

Record an endpoint forSave lower pulse endpointSave higher pulse endpoint

Centers and endpoints persist on the robot. Nothing is enabled.

Stop & test other servoStop & review setup →

KEEP WHAT YOU MEASURED

# Set the usable travel.

Centers and endpoints are kept on the robot as you work. Enter measured angles to apply the S3 aiming limits.

Load saved robot setup

Default aiming speed · head °/s

Pan pulley ratio: 1.5×

The S3 converts shaft angles to head motion using 60T → 40T. Enter shaft measurements once.

Save applies your measured limits on the S3. Any active mast test is stopped automatically.

Apply aiming calibration to S3Go to camera & aim →

Entries save on the robot as you change them. Applying aiming calibration keeps the servos off.

Backup or restore a setup file

Download setup fileLoad file into form

Importing fills the form. Use Save current entries to store them on the robot; apply aiming separately.

OPERATOR VIEW

# See where you're looking.

Live video and mast controls together. Hold an arrow to move; release to stop.

## Live camera

Start videoStop video

◉Camera is off

Start video when you're ready.

Video is not recorded.

Camera picture settings

Read the current settings first. Changes reset on camera reboot.

Read current settings

ResolutionBrightnessExposureAutomatic exposureFlip verticallyMirror horizontally

Apply picture settings

Test a face expression

ExpressionShow for 30 seconds

## Aim the mast

Save a calibration before enabling the mast.

Move to the saved center and enable aiming.Enable mast at center

Mast is off. Enable deliberately when ready.

↑UP

←LEFT◎CENTER→RIGHT

↓DOWN

Aiming speed · °/sApply speed

Stop & holdScan within limitsServos off

Center and scan use the saved S3 limits. Servos off releases holding force. Reconnection never resumes motion.

LIVE DIAGNOSTICS

# Check the robot's health.

Unknown readings remain unknown. No obstacle decisions are made here.

Download diagnostics

## Sensors

Connect to read live telemetry.

Full sensor data

No data

Full mast status

No data

## Recent activity

Gladiator development tools · Movement stays under S3 control
