iThinkiKhan/Gladiator/docs/BUILD_LOG.md

# Build log

[Project home](../README.md) Â· [Photo albums](../photos/README.md)

## Chassis v1

<!-- WRITE: Your build notes. -->

[Photos](../photos/01-chassis-v1/README.md)

## Chassis assembly

<!-- WRITE: Your build notes. -->

[Photos](../photos/02-chassis-assembly/README.md)

## Robot v1

<!-- WRITE: Your build notes. -->

[Photos](../photos/03-robot-v1/README.md)

## Robot v2

<!-- WRITE: Your build notes. -->

[Photos](../photos/05-robot-v2/README.md)

## Event

<!-- WRITE: Your event story. -->

[Photos](../photos/06-event/README.md)
