iThinkiKhan/Gladiator/(commit log)

2026-10-26 Organize Gladiator CAD, firmware, and photo galleries
2026-10-26 Clarify current feature and connection reliability status
2026-10-26 Document masthead revision plans and custom wiring
